immmg/simulador-de-vuelo/Actuador_Lineal_DiseñoGeneral/micro-limit-switch-1a-1.snapshot.5/sensor-final-de-carrera.jpg

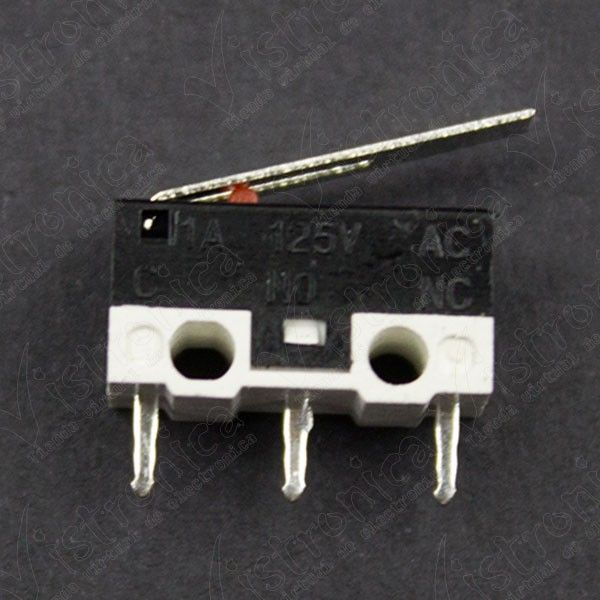
Actuador_Lineal_DiseñoGeneral/micro-limit-switch-1a-1.snapshot.5/sensor-final-de-carrera.jpg
