immmg/simulador-de-vuelo/README.md

# Simulador de Vuelo
Detalles
---
Aqui se subiran todos los detalles referentes al proyecto de diseno de sistemas, el simulador de vuelo
