immmg/simulador-de-vuelo/Especificacion de Requerimientos/Especifiaciones.md

# Especifiacion de requerimientos
* Peso total de carga: `300kg`
* Aviones soportados en la simulacion:
* Programas soportados: `Microsoft Flight Simulator X`
* Volumen Total: 
* Portable y de facil almacenamiento
* Peso total del simulador:
* Controlador: `Arduino Uno`
* Numero de Usuarios: `1`
