immmg/simulador-de-vuelo/Especificacion de Requerimientos/Documento Requerimientos Tecnicos.pdf

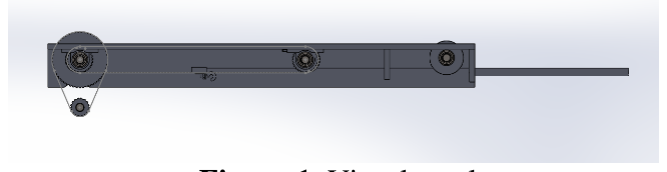
[picture p9: figure]

Mechatronics Engineering Department | Diseño de Sistemas Mecatrónicos
Universidad Católica Boliviana “San Pablo” – Santa Cruz Unit

# Especificaciones Técnicas de un Actuador Lineal para un Simulador de Vuelo

Diego García Bouron
9no. Semestre

Gerardo Viscarra
9no. Semestre

David Aguilera
9no. Semestre

Fernando Soto
9no. Semestre

Germán Ulloa
9no. Semestre

Ing. Erik Pozo
Diseño de Sistemas Mecatrónicos

Abstract—En este documento se describen cuáles son las características técnicas más importantes del actuador lineal que se está diseñando como trabajo final de la materia de Diseño de Sistemas Mecatrónicos.

I. INTRODUCCIÓN
Desde la primera mitad del siglo XX se empezaron a desarrollar simuladores de vuelo para entrenar a pilotos principiantes y evitar siniestros debido a la falta de experticia.

El primer simulador de vuelo fue desarrollado por la compañía francesa Antoinette en 1910 por iniciativa de comandantes de la fuerza aérea francesa. Este simulador contaba con un marco y un barril para reproducir la cabina de vuelo (Vincenzi, Wise, Mouloua, & Hancock, 2009).

Con el paso del tiempo y las necesidades que surgieron debido a las dos guerras mundiales, fueron apareciendo simuladores cada vez más avanzados y sofisticados como el de Edwin Link, el cual contaba con actuadores neumáticos. Este simulador fue muy utilizado por la compañía de correo estadounidense y el Ejército de Estados Unidos durante la Segunda Guerra Mundial (Mechanical & Landmark, 2000).

En 1954 United Airlines compró el primer simulador que incluía sonido e imágenes fabricado por Curttis-Wright. Este fue el primer simulador de vuelo usado para aeronaves comerciales. Este simulador contaba con actuadores hidráulicos lineales (“Airline Pilots Fly Anywhere in the World - Without Leaving the Ground,” 1954).

Los actuadores hidráulicos lineales son actualmente muy utilizados en este tipo de simuladores. Sin embargo, no son el único tipo de actuadores usados. Existen muchos simuladores y propuestas de simuladores que utilizan actuadores eléctricos lineales (Van Roy, 2015).

Actuadores lineales eléctricos: En esta línea existirán una amplia gama de modelos según los motores eléctricos utilizados, siendo necesario, en la mayoría de los casos, la utilización de reductores, debido a que los motores son de operación continua.

Actuador lineal electromecánico: Ideales para realizar levantamientos, aperturas y cierres en cualquier tipo de industria.

En este proyecto se realizará un actuador lineal eléctrico compuesto por un motor DC, una correa dentada para el cambio de movimiento circular a lineal y un pistón. Los aviones modernos son sistemas que requieren de una preparación rigurosa para poder ser pilotados sin riesgo alguno para el piloto mismo y los pasajeros. Por esta razón el uso de simuladores de vuelo es algo menester dentro de la industria aeronáutica.

II. DEFINICIÓN DEL PROBLEMA
Los simuladores de vuelo se caracterizan por sus precios elevados ya que en su mayoría utilizan actuadores hidráulicos. Por esta razón son prácticamente inaccesibles para compañías aeronáuticas pequeñas como las que están presentes en nuestro país.

III. OBJETIVOS

A. Objetivo General

Aplicar los conocimientos adquiridos durante la carrera de Ingeniería Mecatrónica para desarrollar un actuador eléctrico lineal de una plataforma de simulador de vuelo de una aeronave Cessna 177.

B. Objetivos Específicos
- Realizar el diseño mecánico del actuador lineal
- Realizar el diseño eléctrico del sistema
- Realizar la programación del controlador (Arduino Uno)

IV. ESPECIFICACIONES TÉCNICAS

A. Función del Actuador
- Grados de Libertad: 1
- Tipo de movimiento: lineal
- Peso máximo admitido: 50 kg.
- Velocidad de actuación: 0.17 m/s
- Longitud de Carrera: 50,23 cm
B. Casos de Uso para Subproceso
1) Se transmite por serial una velocidad y se recibe por potenciómetro retroalimentación.
2) Se acción uno de los finales de carrera deteniendo el actuador.
V. PROPUESTA TÉCNICA
A. Diseño General

Figura 1. Vista lateral

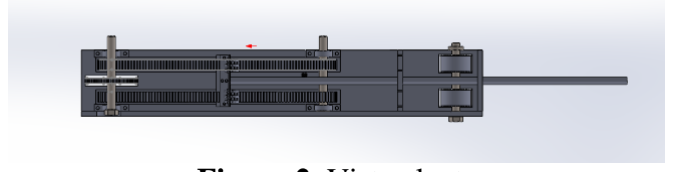
[picture p10: figure]

Figura 2. Vista planta

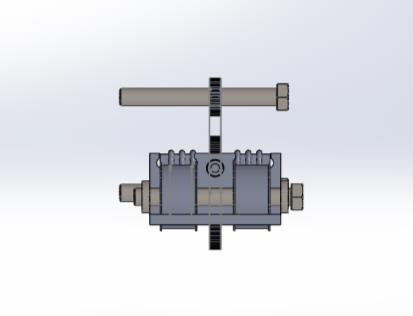
[picture p11: figure]

Figura 3. Vista frontal

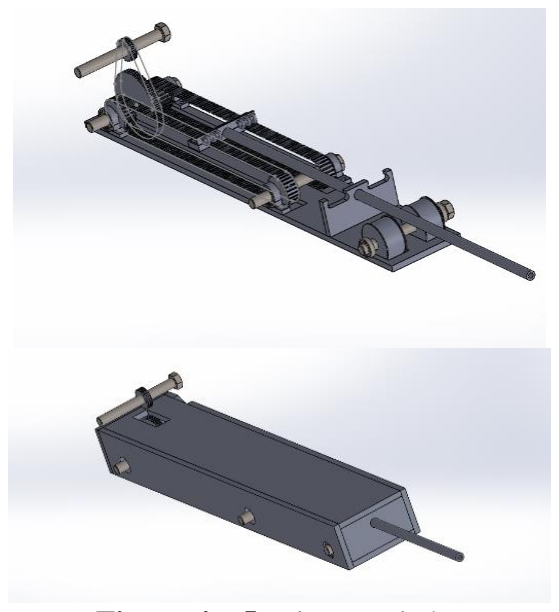
[picture p12: figure]

Figura 4 y 5. Vistas variadas

Existen vistas detalladas por pieza. Véase anexo de planos de piezas

B. Materiales y Descripcion
El actuador al estar construido constituirá de los componentes descritos en la tabla 1.

Tabla 1. Resumen de componentes presentes en el actuador

C. Diseño Estructural
a. Cálculo de Poleas
El sistema de poleas empleado en el proyecto es el que se muestra en la figura 6. La polea 1 está conectada directamente al motor, por lo tanto, esta recibe la velocidad y torque del motor.

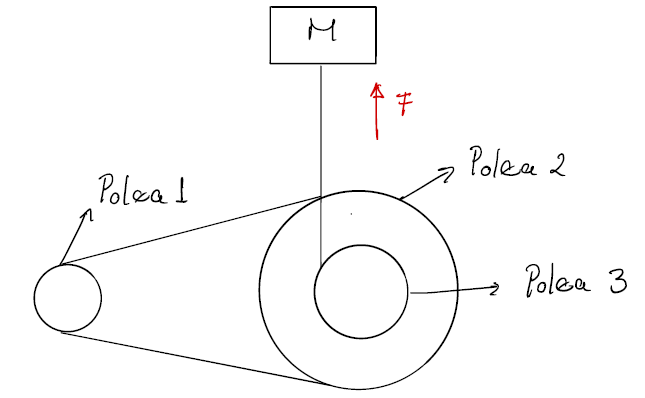
[picture p13: figure]

Figura 6. Sistema de Poleas

Se determinó cuál es el torque de salida y el esfuerzo que soporta, siendo las variables utilizadas las siguientes:
i = relación de transmisión
w1 = velocidad angular polea 1 [rpm]
w2 = velocidad angular polea 2 [rpm] w3 = velocidad angular polea 3 [rpm] F = Fuerza [N]
τ
1 = torque polea 1 [Nm]
τ
2 = torque polea 2 [Nm]
τ
3 = torque polea 3 [Nm]
r1 = radio polea 1 [m]
r2 = radio polea 1 [m]
r3 = radio polea 1 [m]
Se sabe que los valores de los radios son los siguientes:

1

2

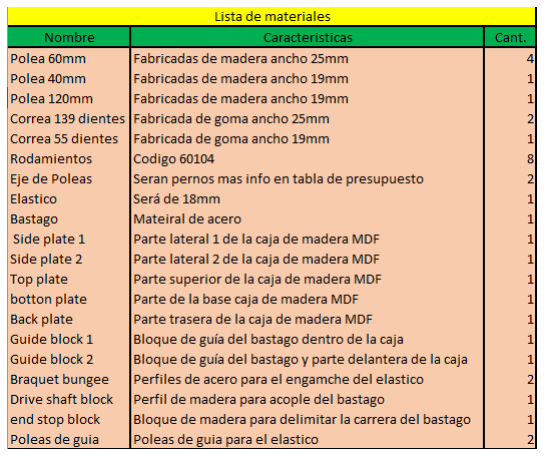
[picture p14: figure]

3

1

1

0.02
0.06
0.03
2.2
161
r | m
r | m
r | m
| Nm
| rpm

τ
ω

=
=
=
=
=

La ecuación de torque es:

### τ =· Fr

(1)

La relación de velocidades y radios es:

1 | 1 | 2 | 2
1 | 2
2 | 1

1

r r
r
r | i
ω | ω
ω
ω
- = ·

= =

(2)

La relación de velocidades y torques es:

1 | 1 | 2 | 2
1 | 2
2 | 1

1
i

### τ ω τ ω

τ | ω
τ | ω
- | = | ·
= | =

(3)

Partiendo de la ecuación (2), tenemos que:

1

2

0.02
0.06
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
Usando la ecuación (3) y como la polea 3 está en el mismo eje que polea 2, se tiene:

3 1

3

| 3
| 3

6.6

6.6 220
0.03

i
Nm

F
r
Nm F | N
m

ττ
τ
τ

=·
=

=

= | =

Por lo tanto, la fuerza que soporta el motor es de 220N

b. Cálculo de elásticos

En este proyecto se utiliza elástico de lycra que tiene la cualidad de estirarse hasta un 500% sin que se rompa. Esta cuerda se utiliza como el elástico que ayudará al motor a soportar los 50 kg deseados, como se puede ver en la figura 7. Para esto se determinó su coeficiente de elasticidad experimentalmente usando una cuerda de 1.3m que es el largo que se usará en este actuador y luego sometimos a diferentes esfuerzos para calcular diferentes coeficientes de elasticidad con la ecuación (2).

F | k x = - · (4) F
k | x
=-
(5)

Siendo:
k = coeficiente de elasticidad [N/m] F = fuerza empleada [N]
x = deformación [m]

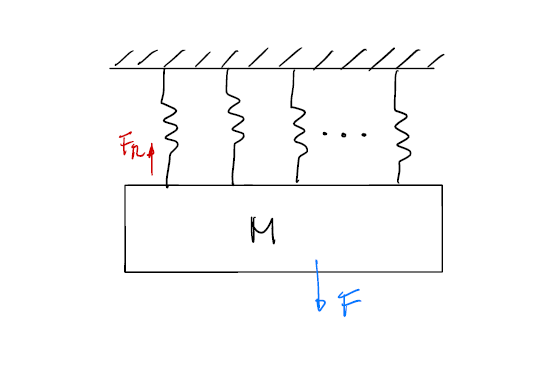
[picture p15: figure]

Figura 7. Sistema de Elásticos

En las pruebas realizadas se obtuvieron varios coeficientes de elasticidad con diferentes medidas de elásticos para comprobar la veracidad de las mismas. Se utilizaron las medidas de 0.25m, 0.5m, 1m y 1.3m y se concluyó que al variar la longitud del elástico la constante cambia. Entonces, mientras la cuerda sea más larga el coeficiente de k será menor.
En la Tabla 2 se muestran los datos obtenidos experimentalmente de la constante k.

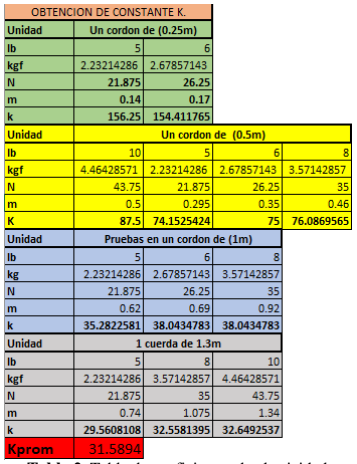
[picture p16: figure]

Tabla 2. Tabla de coeficientes de elasticidad y esfuerzos aplicados

Se sabe que la salida de la polea 3 es de 220 N que dividido por la fuerza de gravedad (9.8m/s^2) da como resultado 22 kg aproximadamente. Esto significa que nuestro elástico debe soportar 27.55 kg para cumplir con los 50 kg deseados. Por lo tano:

27.55

270

m | kg

### F m g

F N

=
=·
≅

Sabiendo que una cuerda de 1.3m tiene un coeficiente de elasticidad k=31.6nN/m y que la máxima deformación permitida es de 0.7m, con la ecuación (1) se determina que el esfuerzo que puede soportar un elástico es el siguiente:

31.6 | 0.7 | 22.12 N
F | m | N
m
= | · | =

Como se desea cargar 270N, dividimos el esfuerzo deseado entre lo que soporta un solo elástico y de esta manera sacamos la cantidad de elásticos necesarios.

270 12.27
22

=

Utilizando un factor de seguridad del 1.2 se calcula la cantidad de elásticos final con la siguiente formula:

e f | e n | n n = | ·

nef = # de elásticos final
ne = # de elásticos
n = factor de seguridad

Por lo tanto, el número de elásticos final es de 15 elásticos como se aprecia en la ecuación (3):

12.27 1.2 15 ef n = | · | ≅
(6)
c. Lista de Materiales Mecánicos

Los materiales mecánicos a utilizar y sus precios se muestran en la tabla 3.

Tabla 3. Materiales Mecánicos y Precios

Para encontrar una versión de mayor calidad de la tabla 3 véase anexos.

D. Diseño Electrico
a. Voltaje necesario: 19V
b. Corriente Necesaria:
Tomando en cuenta la ecuación (7) de la corriente del motor DC en función de la fuerza requerida (Ogata, 2013), se puede sacar la corriente necesaria:

a
t

F
I
k

=
(7)

Donde:
Ia = Corriente requerida [A]
F = Fuerza requerida [N]
Kt = constante electromecánica del motor [N/A]

Sabemos que el torque del motor es 2.2Nm, el radio de la polea 1 es 0.002m. Si utilizamos la ecuación
(1) podemos obtener la fuerza requerida.
E. Analisis de motores y eleccion

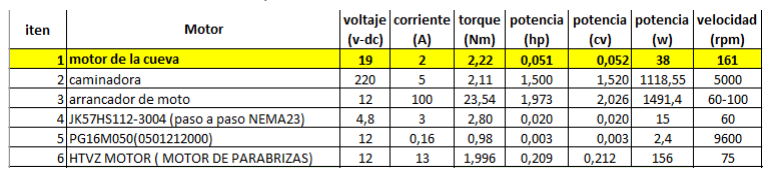
[picture p17: figure]

Tabla 4. Análisis de motores candidatos

Para encontrar una versión de mayor calidad de la tabla 4 véase anexos.

Se utilizará el motor de la cueva ya que este cumple con los requisitos buscados para este proyecto, que son un buen par motor, y consumo aceptable, en comparación a las demás propuestas, el siguiente a ser escogido es el motor caminador, por la disponibilidad inmediata. El siguiente será el arrancador de moto.

F. Velocidad Máxima del Actuador sin carga
Tomando en cuenta que la relación del sistema obtenida en la sección C.a fue de 1/3 y que la velocidad del actuador elegido es de 161 rpm se puede calcular a través de la siguiente formula la velocidad de salida:
ωf = i ∙ ωi

Entonces:
ωf ≅ 54 rev/min

Convirtiendo a rad/seg:

54

rev
min

∙

2π rad
1 rev

∙

1 min
60 s

= 5.7

rad
seg

Sabiendo que la fórmula para transformar velocidad angular a lineal es:
V = ω ∙ r

Y sabiendo que el radio de la polea de salida es 0.03m, entonces:

V = 5.7

rad
seg

∗ 0.03m

V = 0.17

m
s
G. Elección de Fuente
Esta fuente tiene las siguientes características: 24Vdc y 5A. Ya que el consumo del motor es de 19V y 3A. La figura 8 muestra una fuente comercial de estas características

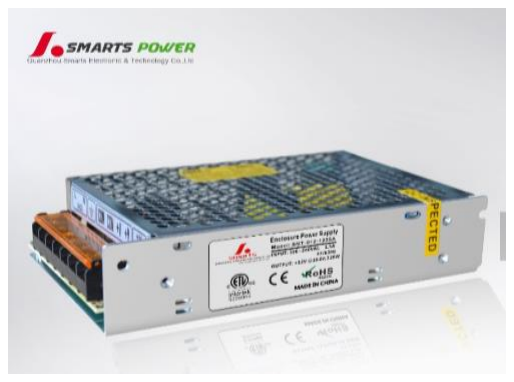
[picture p18: figure]

Figura 8. Imagen ilustrativa del tipo de fuente

H. Diseño Electronico y computacional
a. Diseño Electrónico

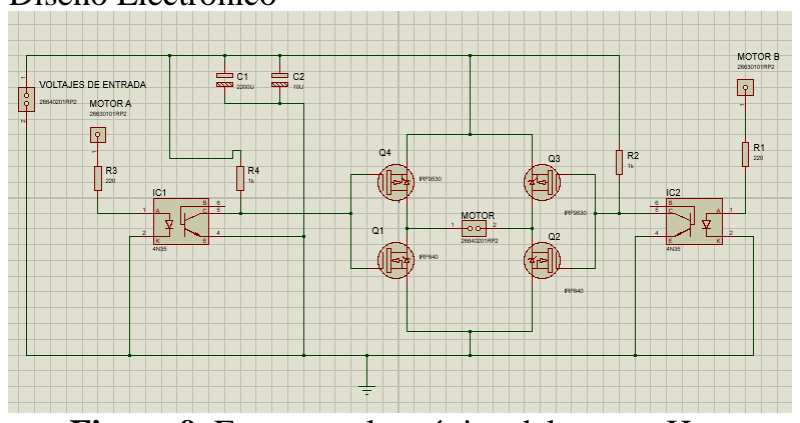
[picture p19: figure]

Figura 9. Esquema electrónico del puente H

Descripcion | Codigo | Precio/Item | Cant. | Subtotal [BOB] 135 160 50 33 180 60 10 106,8 40
Venesta de MDF 1.83 x 1.375 12mm Rodamientos Pernos 20M - 140 longitud Venesta de MDF 2,8mm Correa 25M Correa 19M Pernos M6 Elastico Ganchos | 61904 24018 Precio por metro | 135,00 20,00 25,00 33,00 90,00 60,00 0,50 8,90 2,00 | 1 8 2 1 2 1 20 12 20
SUBTOTAL | | | | 774,8

PRESUPUESTO DE PARTES MECANICAS

La figura 9 muestra el esquema electrónico del puente H propuesto para el control de giro y velocidad del actuador. Para mayor detalle véase Anexo de Plano Electrónico

b. Lista de Materiales Electrónicos
Los materiales electrónicos utilizar y sus precios se muestran en la tabla 5. Existe una versión más detallada en los anexos

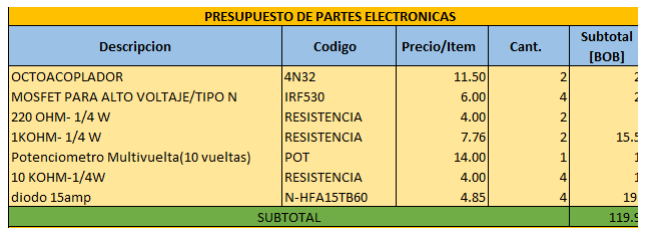
[picture p20: figure]

Tabla 5. Materiales Electrónicos y precios

c. Diseño computacional
Al usar Arduino para el control del actuador se utilizara por conveniencia el Arduino IDE, el cual fuerza a usar una estructura de programa con dos funciones básicas, una de ajuste y otra de repetición infinita como se muestra en el diagrama de flujo de la figura 10. Una versión de más detalle de este diagrama existe en los anexos


Figura 10. Diagrama de flujo de programación

- Interfaz de usuario: Monitor serial de Arduino IDE
- Entradas: Potenciómetros, Final de Carrera
- Salidas: Control PWM
I. Cronograma
Véase anexo de cronograma
J. Propuesta Economica
La propuesta económica es de 1302.88 bolivianos (Véase anexos).

VI. REFERENCIAS

Ogata, K. (2013). Ingeniería de Control Moderna. Journal of Chemical
Information | and | Modeling | (Vol. | 53).
https://doi.org/10.1017/CBO9781107415324.004

Van Roy, R. (2015). Simproject.nl.
Airline Pilots Fly Anywhere in the World - Without Leaving the Ground. (1954). Popular Mechanics.
Mechanical, A. H., & Landmark, E. (2000). The Link Flight Trainer. Vincenzi, D. A., Wise, J. A., Mouloua, M., & Hancock, P. A. (Eds.). (2009). Human Factors in Simulation and Training. CRC Pr

ID | Nombre de tarea | Duration | Start | Finish | Predecessors
1 | Actudor Lineal para plataforma de simulador de Vuelo 79,25 days | | Mon 1/4/19 | Fri 21/6/19
2 | Definición de Cronograma | 5 days | Mon 1/4/19 | Fri 5/4/19
3 | Diseño Estructural | 73,38 days | Mon 1/4/19 | Sat 15/6/19
4 | Busqueda de Bibliografía | 2 days | Mon 1/4/19 | Tue 2/4/19
5 | Diseño de Partes Estructurales | 5 days | Wed 3/4/19 | Tue 9/4/19 | 4
6 | Selección de materiales a ser utilizadas2 days | | Wed 10/4/19 | Thu 11/4/19 | 5
7 | Determinar presupuesto de partes | 2 days | Thu 25/4/19 | Fri 26/4/19
8 | Compra de materiales | 2 days | Sat 18/5/19 | Mon 20/5/19 | 6
9 Mecanisado de Poleas con la | cortadora 3D | 5 days | Tue 21/5/19 | Sun 26/5/19 | 8
10 Cortado de las piezas de la caja del | actuador con la cortadora 3D | 8 days | Wed 22/5/19 | Thu 30/5/19
11 | Prueba de resistencia de las poleas | 2 days | Sun 26/5/19 | Tue 28/5/19 | 9
12 | Ensamblado de la estructura | 10 days | Fri 31/5/19 | Mon 10/6/19
13 | Pruebas Mecanicas del actuador | 10 days | Wed 5/6/19 | Sat 15/6/19
14 | Diseño Eléctrico | 52,5 days | Mon 1/4/19 | Sat 25/5/19
15 | Busqueda de Bibliografía | 2 days | Mon 1/4/19 | Tue 2/4/19
16 Diseño de Circuitos de Alimentación | Eléctrica | 3 days | Wed 3/4/19 | Fri 5/4/19 | 15
17 | Materiales eléctricos a utilizar | 2 days | Sat 6/4/19 | Mon 8/4/19 | 16
18 | Presupuesto Electrico | 38,75 days | Mon 1/4/19 | Fri 10/5/19
19 | Compra de materiales | 3 days | Sat 11/5/19 | Tue 14/5/19 | 18
20 Documento de Comparacion de | Motores | 5 days | Mon 22/4/19 | Fri 26/4/19
21 Ensablado de circuito de | alimentacion | 10 days | Wed 15/5/19 | Sat 25/5/19 | 19
22 | Pruebas del circuito de alimentacion | 3 days | Fri 26/4/19 | Mon 29/4/19
23 | Obtencion de parametros del motor | 4 days | Fri 10/5/19 | Tue 14/5/19
24 | Modelo matematico del motor Toshiba9 days | | Wed 10/4/19 | Fri 19/4/19
25 | Diseño Electrónico / Computacional | 69,75 days | Mon 1/4/19 | Wed 12/6/19
26 | Busqueda de Bibliografía | 2 days | Mon 1/4/19 | Tue 2/4/19
27 | Diseño de Circuito Electrónicos | 2 days | Wed 3/4/19 | Thu 4/4/19 | 26
28 Diseño Computacional y Algoritmos | de Drivers | 1 wk | Wed 3/4/19 | Mon 8/4/19 | 26
29 | Materiales Electrónicos | 3 days | Mon 8/4/19 | Thu 11/4/19 | 28
30 | Presupuesto Electrónico | 15 days | Thu 25/4/19 | Fri 10/5/19
31 | Compra de materiales electronicos | 5,75 days | Sat 11/5/19 | Thu 16/5/19 | 30
32 | Diseño de interfaz de control | 32 days | Fri 10/5/19 | Wed 12/6/19
33 Diseño del diagrama de bloques del | sistema | 15 days | Thu 9/5/19 | Fri 24/5/19
34 | Propuesta Económica | 3 days | Thu 25/4/19 | Sun 28/4/19 | 29

Encargado | % Complete
Todo el equipo | 25%

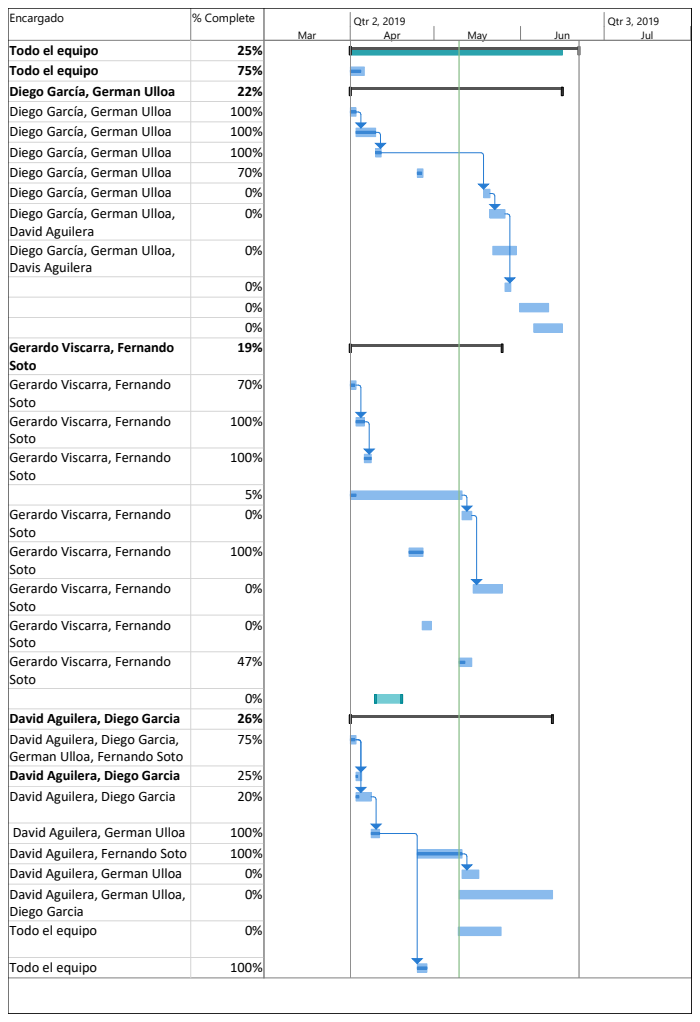
[picture p21: page 7]
Mar; Apr; May; Jun; Jul; Qtr 2, 2019; Qtr 3, 2019

Todo el equipo | 75%
Diego García, German Ulloa | 22%
Diego García, German Ulloa | 100%
Diego García, German Ulloa | 70%
Diego García, German Ulloa | 0%
Diego García, German Ulloa, David Aguilera | 0%

Diego García, German Ulloa, Davis Aguilera | 0%

0%

Gerardo Viscarra, Fernando Soto | 19%

Gerardo Viscarra, Fernando Soto | 70%

Gerardo Viscarra, Fernando Soto | 100%

Gerardo Viscarra, Fernando Soto | 0%

Gerardo Viscarra, Fernando Soto | 47%

David Aguilera, Diego Garcia | 26%
David Aguilera, Diego Garcia, German Ulloa, Fernando Soto | 75%

David Aguilera, Diego Garcia | 25%
David Aguilera, Diego Garcia | 20%

David Aguilera, German Ulloa | 100%
David Aguilera, Fernando Soto | 100%
David Aguilera, German Ulloa | 0%
David Aguilera, German Ulloa, Diego Garcia | 0%

Todo el equipo | 0%

Todo el equipo | 100%

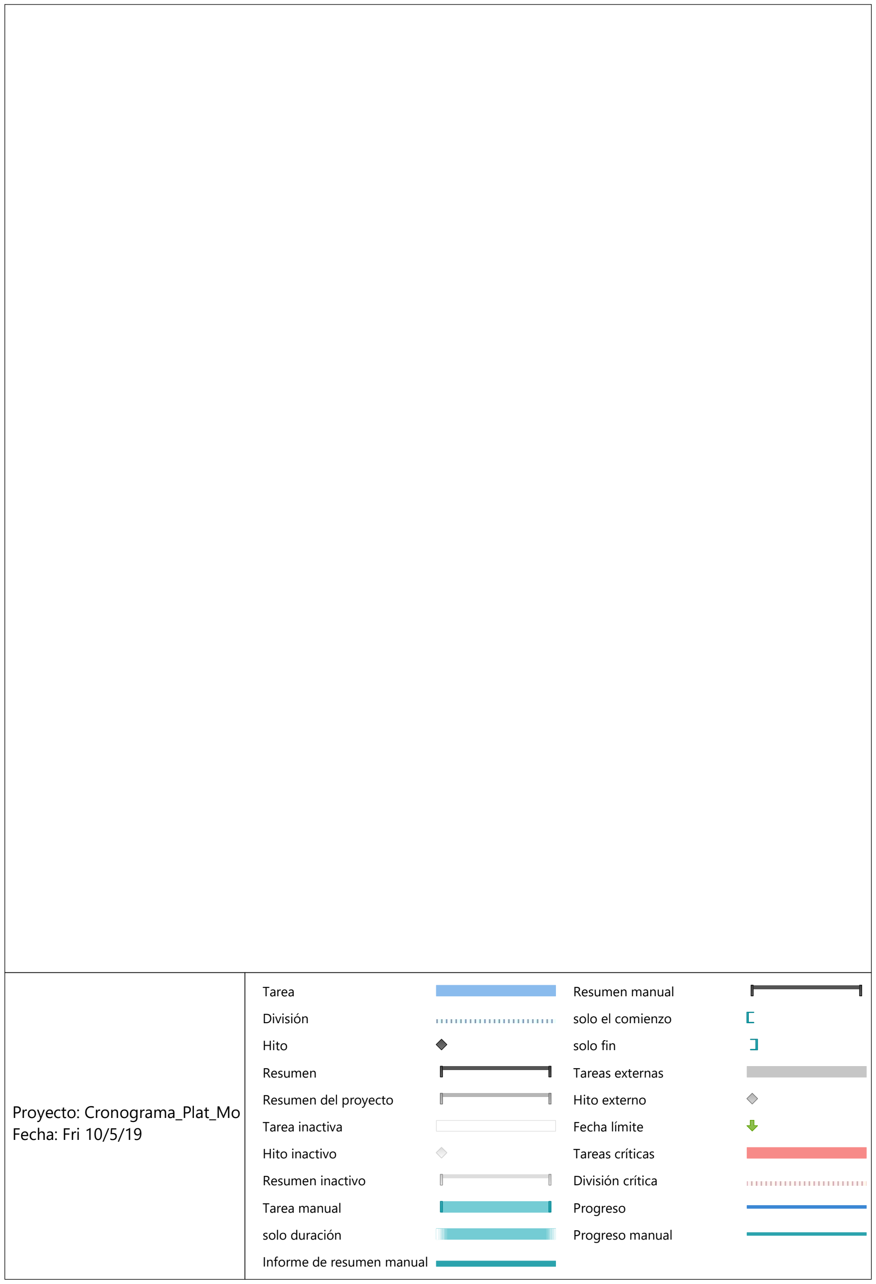
[picture p22: figure]
Tarea; División; Hito; Resumen; Resumen del proyecto; Tarea inactiva; Hito inactivo; Resumen inactivo; Tarea manual; solo duración; Informe de resumen manual; Resumen manual; solo el comienzo; solo fin; Tareas externas; Hito externo; Fecha límite; Tareas críticas; División crítica; Progreso; Progreso manual; Proyecto: Cronograma_Plat_Mo Fecha: Fri 10/5/19

### Lista de Materiales Mecanicos Presentes en el Actuador

Nombre | Caracteristicas | Cant.
Polea 60mm | Fabricadas de madera ancho 25mm | 4
Polea 40mm | Fabricadas de madera ancho 19mm | 1
Polea 120mm | Fabricadas de madera ancho 19mm | 1
Correa 139 dientes | Fabricada de goma ancho 25mm | 2
Correa 55 dientes | Fabricada de goma ancho 19mm | 1
Rodamientos | Codigo 60104 | 8
Eje de Poleas | Seran pernos mas info en tabla de presupuesto | 2
Elastico | Será de 18mm | 1
Bastago | Mateiral de acero | 1
Side plate 1 | Parte lateral 1 de la caja de madera MDF | 1
Side plate 2 | Parte lateral 2 de la caja de madera MDF | 1
Top plate | Parte superior de la caja de madera MDF | 1
botton plate | Parte de la base caja de madera MDF | 1
Back plate | Parte trasera de la caja de madera MDF | 1
Guide block 1 | Bloque de guía del bastago dentro de la caja | 1
Guide block 2 | Bloque de guía del bastago y parte delantera de la caja | 1
Braquet bungee | Perfiles de acero para el engamche del elastico | 2
Drive shaft block | Perfil de madera para acople del bastago | 1
end stop block | Bloque de madera para delimitar la carrera del bastago | 1
Poleas de guia | Poleas de guia para el elastico | 2

Lista de materiales

### Obtencion de Constante K - Resultados de los experimentos

Unidad | Un cordon de (0.25m)
lb | 5 | 6
kgf | 2.23214286 | 2.67857143
N | 21.875 | 26.25
m | 0.14 | 0.17
k | 156.25 | 154.411765
Unidad | Un cordon de (0.5m)
lb | 10 | 5 | 6 | 8
kgf | 4.46428571 | 2.23214286 | 2.67857143 | 3.57142857
N | 43.75 | 21.875 | 26.25 | 35
m | 0.5 | 0.295 | 0.35 | 0.46
K | 87.5 | 74.1525424 | 75 | 76.0869565
Unidad | Pruebas en un cordon de (1m)
lb | 5 | 6 | 8
kg | 2.23214286 | 2.67857143 | 3.57142857
N | 21.875 | 26.25 | 35
m | 0.62 | 0.69 | 0.92
k | 35.2822581 | 38.0434783 | 38.0434783
Unidad | 1 cuerda de 1.3m
lb | 5 | 8 | 10
kgf | 2.23214286 | 3.57142857 | 4.46428571
N | 21.875 | 35 | 43.75
m | 0.74 | 1.075 | 1.34
k | 29.5608108 | 32.5581395 | 32.6492537
Kprom | 31.5894

OBTENCION DE CONSTANTE K.

### Analisis de Motores

item | Motor | voltaje(v-dc) | corriente(A) | torque(Nm) | potencia(hp) | potencia(cv) | potencia(w) | velocidad(rpm)
1 2 3 4 5 6 | motor de la cueva caminadora arrancador de moto JK57HS112-3004 (paso a paso NEMA23) PG16M050(0501212000) HTVZ MOTOR (motor de parabrisas) | 19,000 220,000 12,000 4,800 12,000 12,000 | 2,000 5,000 100,000 3,000 0,160 13,000 | 2,222 2,106 23,540 2,800 0,980 1,996 | 0,051 1,500 1,973 0,020 0,003 0,209 | 0,052 1,520 2,026 0,020 0,003 0,212 | 38,000 1118,550 1491,400 15,000 2,400 156,000 | 161,000 5000,000 60-100 60,000 9600,000 75,000

82,00

# Botton plate - planta

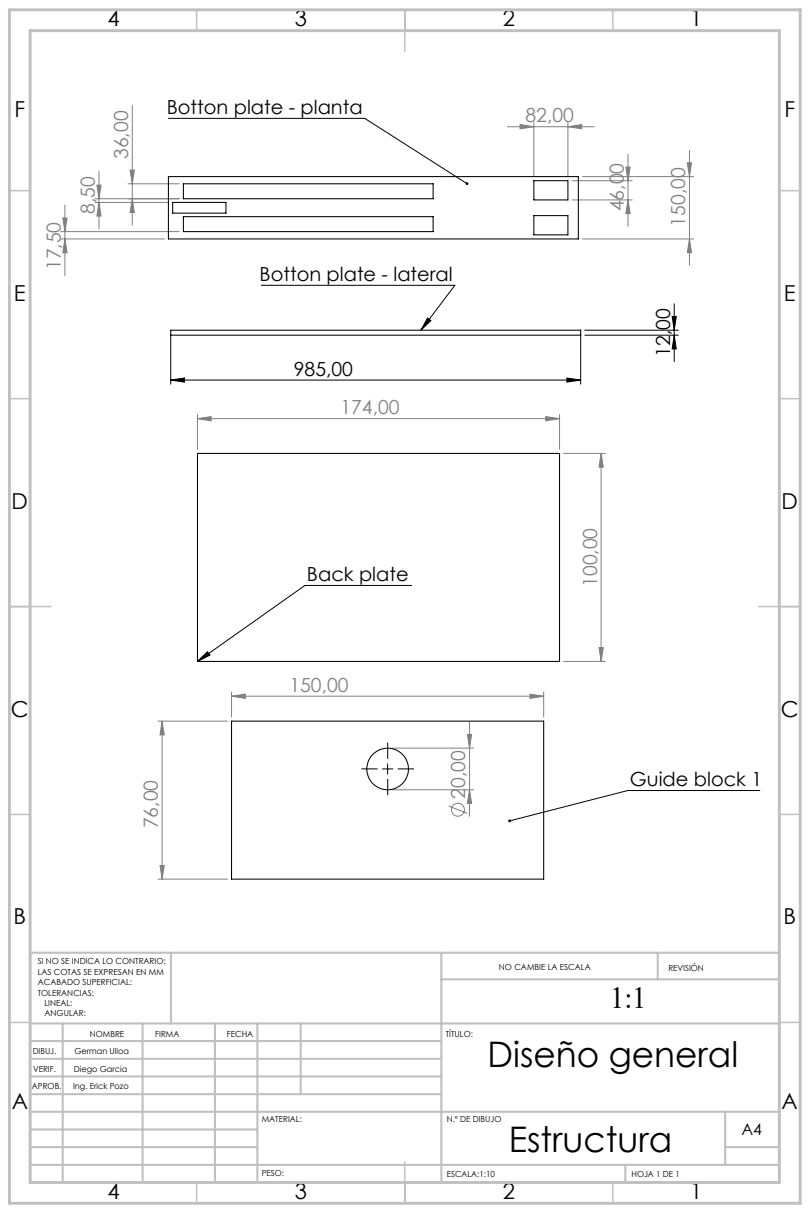
[picture p23: page 12]
Back plate; Guide block 1; MATERIAL:; NO CAMBIE LA ESCALA; REVISIÓN; N.º DE DIBUJO; ESCALA:1:10; HOJA 1 DE 1; PESO:; Estructura

Botton plate - lateral

SI NO SE INDICA LO CONTRARIO:
LAS COTAS SE EXPRESAN EN MM
ACABADO SUPERFICIAL:
TOLERANCIAS:
LINEAL:
ANGULAR:

NOMBRE | FIRMA | FECHA | TÍTULO: Diseño general

DIBUJ. | German Ulloa
VERIF. | Diego Garcia
APROB. | Ing. Erick Pozo

20,00

150,00

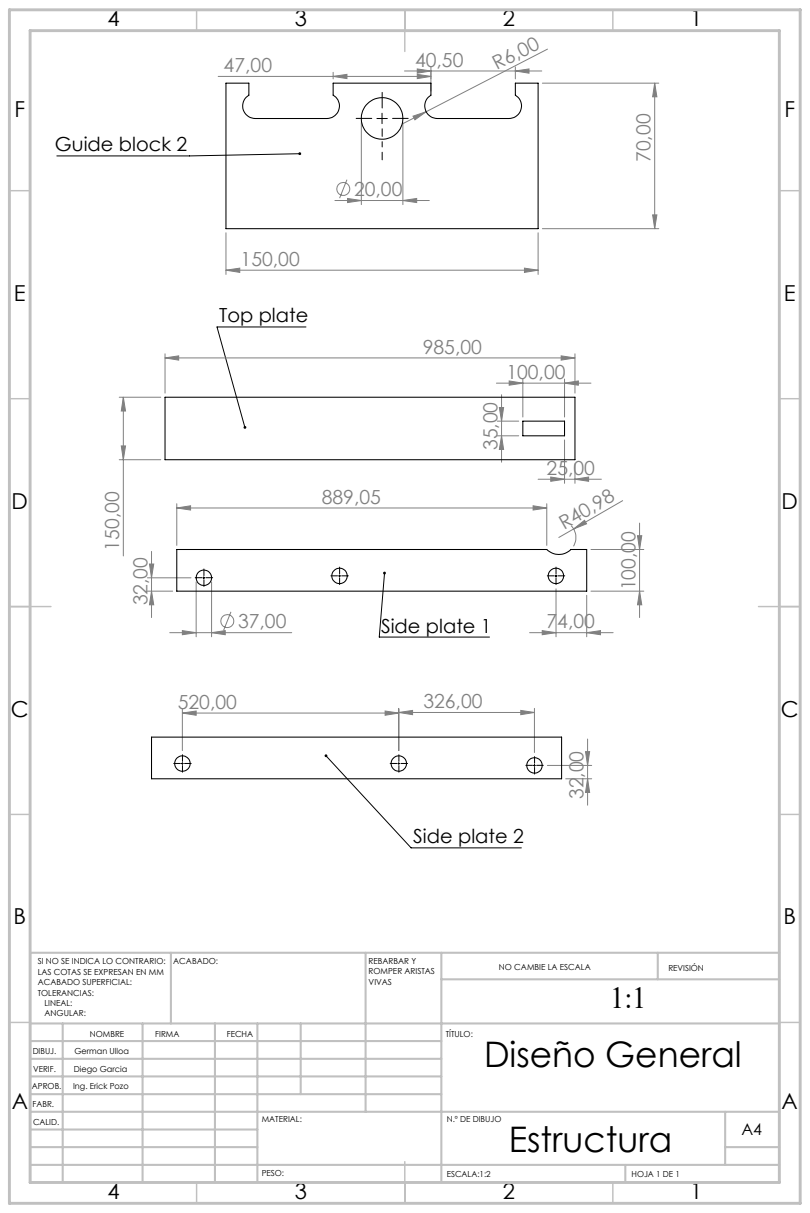
[picture p24: page 13]
Guide block 2; Top plate; Side plate 1; Side plate 2; ACABADO:; REBARBAR Y; ROMPER ARISTAS VIVAS; NO CAMBIE LA ESCALA; REVISIÓN; ESCALA:1:2; HOJA 1 DE 1; PESO:

SI NO SE INDICA LO CONTRARIO:
LAS COTAS SE EXPRESAN EN MM
ACABADO SUPERFICIAL:
TOLERANCIAS:
LINEAL:
ANGULAR:

NOMBRE | FIRMA | FECHA | | | | TÍTULO: Diseño General

DIBUJ. | German Ulloa
VERIF. | Diego Garcia
APROB. | Ing. Erick Pozo
FABR.
CALID. | | | | MATERIAL: | N.º DE DIBUJO Estructura | A4

3,00 25,00
136,00

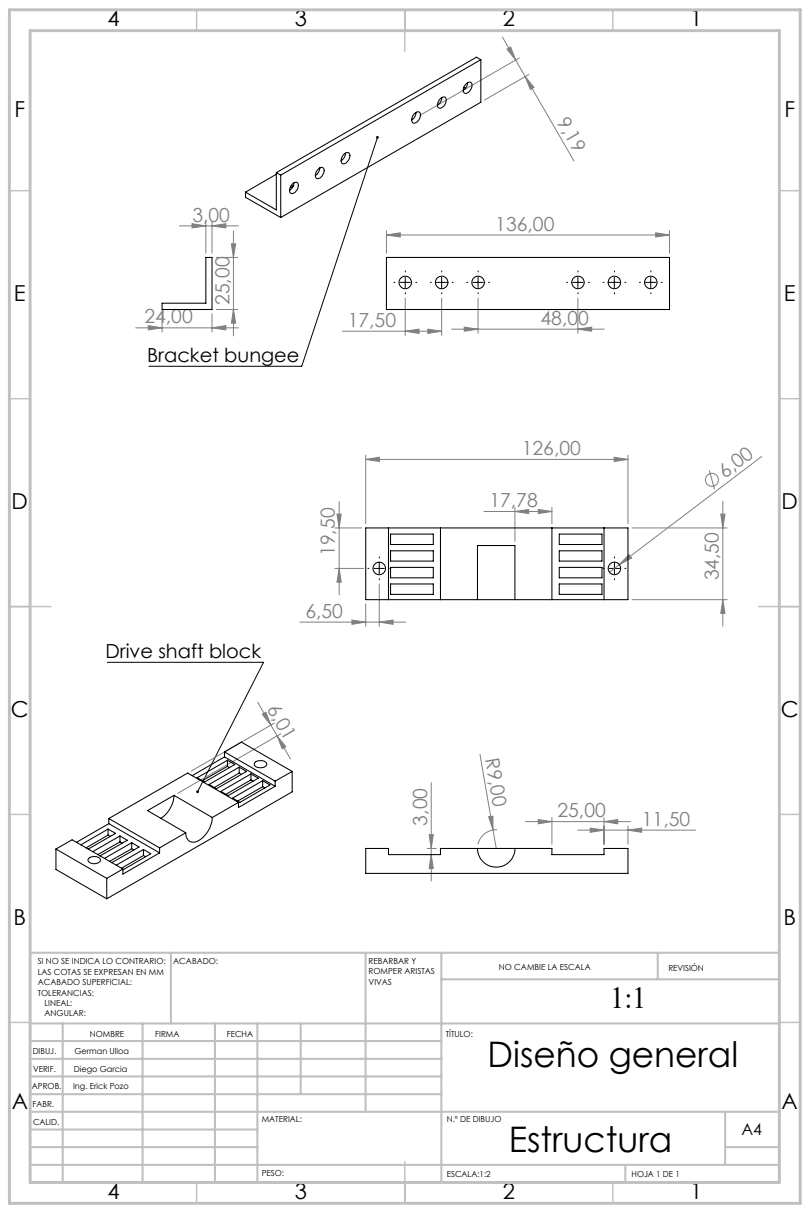
[picture p25: page 14]
Bracket bungee; ACABADO:; REBARBAR Y; ROMPER ARISTAS VIVAS; NO CAMBIE LA ESCALA; REVISIÓN; ESCALA:1:2; HOJA 1 DE 1; PESO:

Drive shaft block

SI NO SE INDICA LO CONTRARIO:
LAS COTAS SE EXPRESAN EN MM
ACABADO SUPERFICIAL:
TOLERANCIAS:
LINEAL:
ANGULAR:

NOMBRE | FIRMA | FECHA | | | | TÍTULO: Diseño general

DIBUJ. | German Ulloa
VERIF. | Diego Garcia
APROB. | Ing. Erick Pozo
FABR.
CALID. | | | | MATERIAL: | N.º DE DIBUJO Estructura | A4

# Polea de 40 mm

# Polea de 60 mm

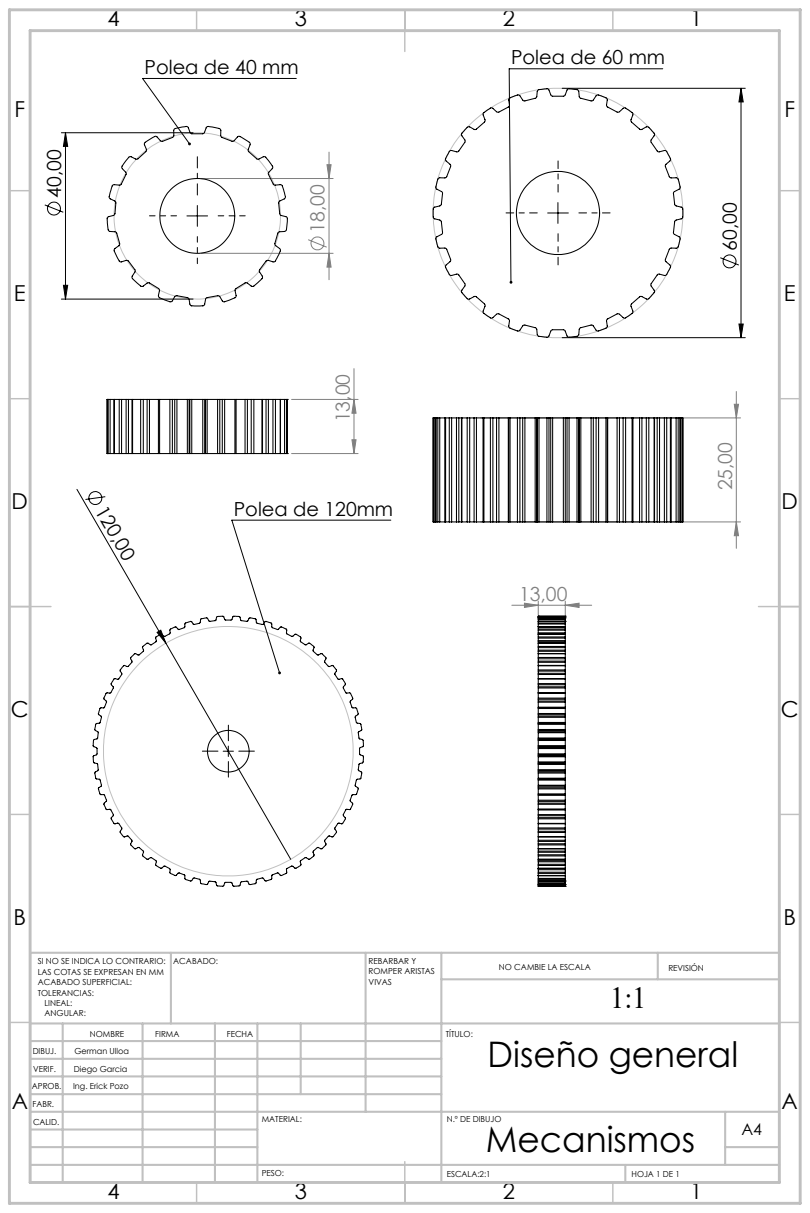
[picture p26: page 15]
Polea de 120mm; ACABADO:; REBARBAR Y; ROMPER ARISTAS VIVAS; NO CAMBIE LA ESCALA; REVISIÓN; ESCALA:2:1; HOJA 1 DE 1; PESO:

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

NOMBRE | FIRMA | FECHA | | | | TÍTULO: Diseño general

DIBUJ. | German Ulloa
VERIF. | Diego Garcia
APROB. | Ing. Erick Pozo
FABR.
CALID. | | | | MATERIAL: | N.º DE DIBUJO Mecanismos | A4

A

B

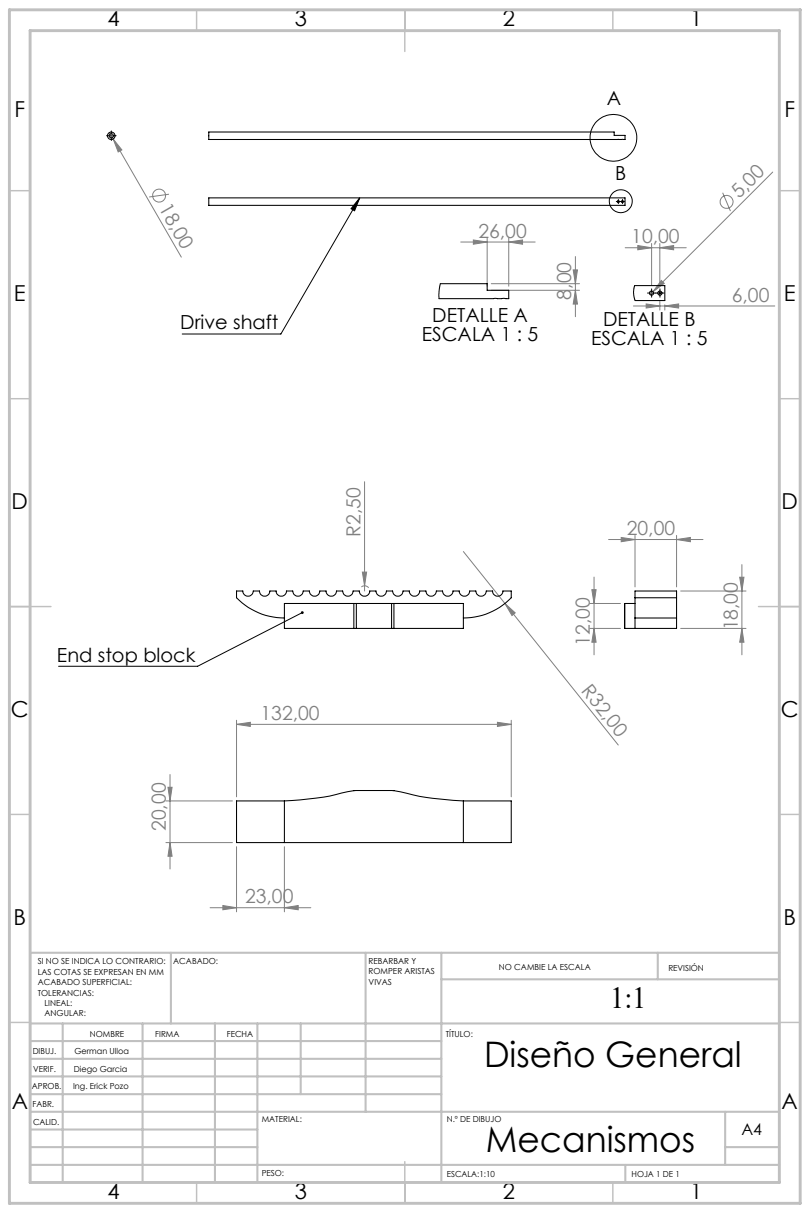
[picture p27: page 16]
Drive shaft; DETALLE A ESCALA 1 : 5; DETALLE B ESCALA 1 : 5; ACABADO:; REBARBAR Y; ROMPER ARISTAS VIVAS; NO CAMBIE LA ESCALA; REVISIÓN; ESCALA:1:10; HOJA 1 DE 1; PESO:

End stop block 20,00

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

NOMBRE | FIRMA | FECHA | | | | TÍTULO: Diseño General

DIBUJ. | German Ulloa
VERIF. | Diego Garcia
APROB. | Ing. Erick Pozo
FABR.
CALID. | | | | MATERIAL: | N.º DE DIBUJO Mecanismos | A4

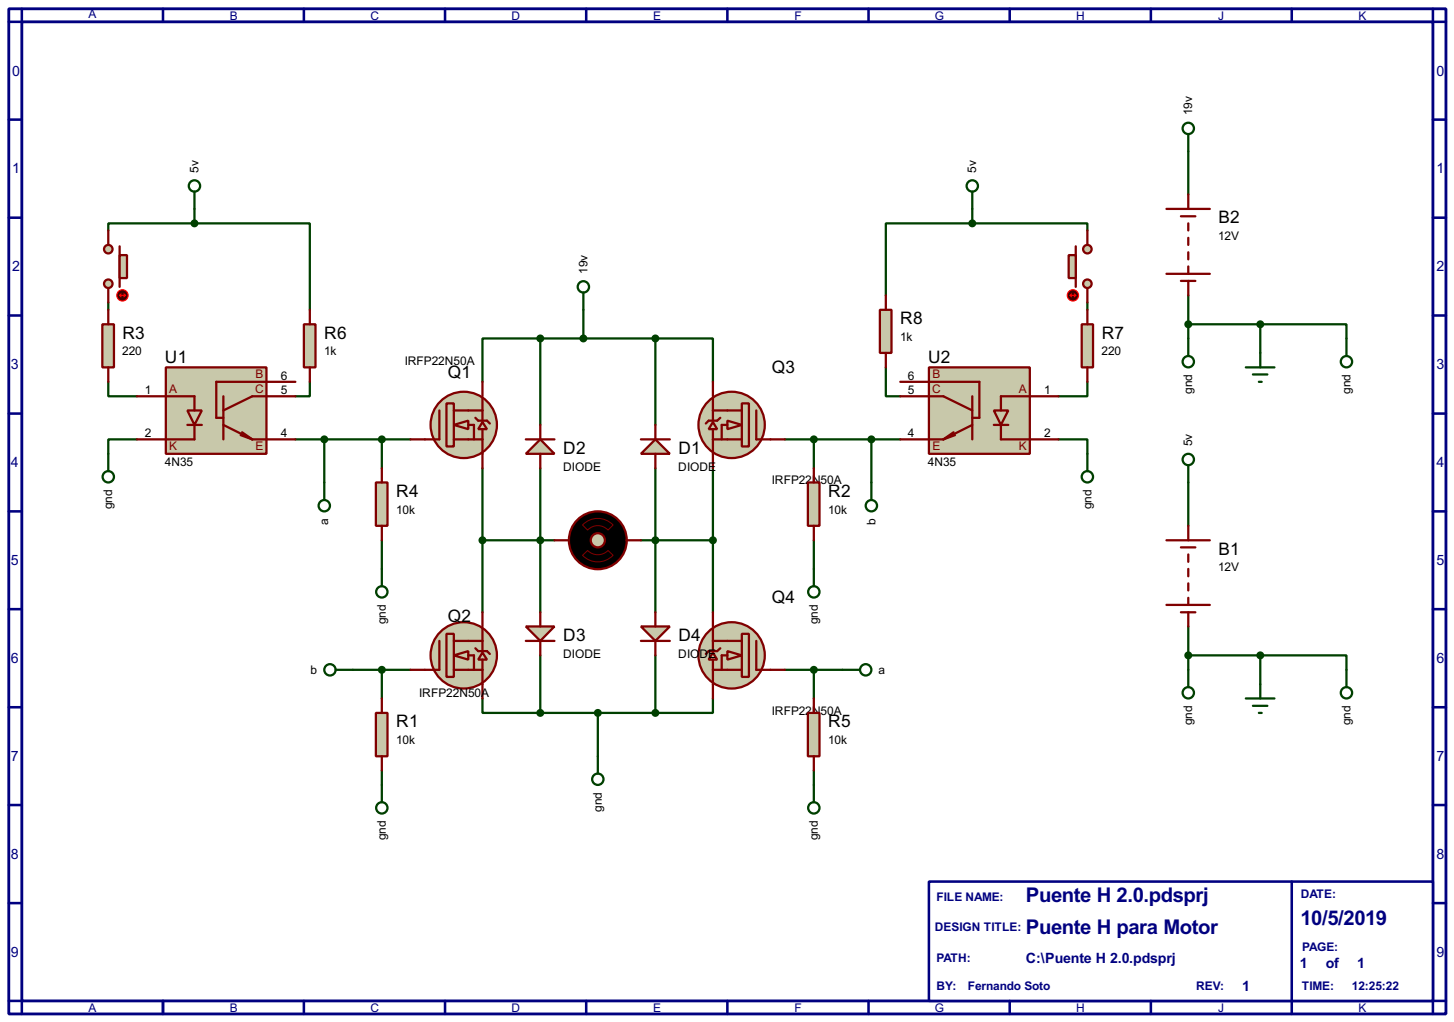
[picture p28: page 17]

FILE NAME:
DESIGN TITLE: Puente H para Motor

IMMMG INGENIERIA | https://github.com/immmg

# ACTUADOR LINEAL

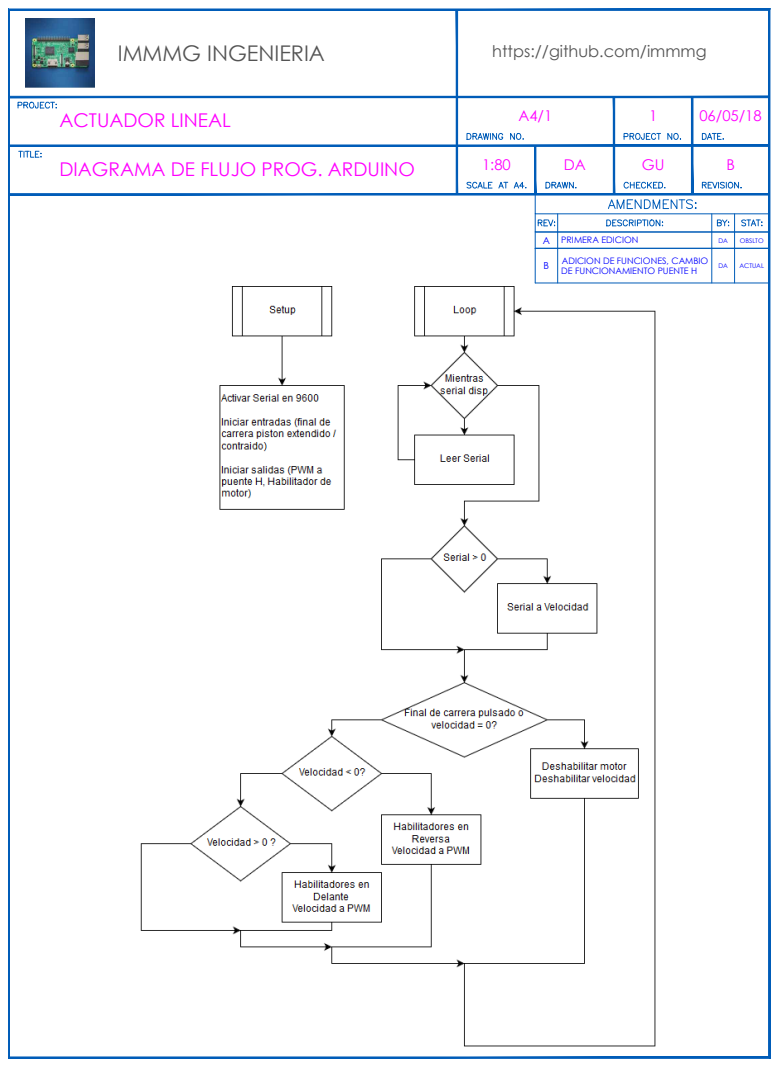
[picture p29: page 18]
PRIMERA EDICION; OBSLTO; ADICION DE FUNCIONES, CAMBIO; DE FUNCIONAMIENTO PUENTE H; ACTUAL

DIAGRAMA DE FLUJO PROG. ARDUINO
