immmg/simulador-de-vuelo/Especificacion de Requerimientos/Requisitos Técnicos.pdf

Requisitos Técnicos

Actuador Simulador de Vuelo

### 1. Función del Actuador

a. Grados de Libertad: 1
b. Tipo de movimiento: lineal
c. Peso máximo admitido: 50 kg.
d. Velocidad de actuación: 0.5 m/s
e. Aceleración de actuación:
f. Longitud de Carrera: 50,23 cm

### 2. Casos de Usos para Subprocesos

a. Caso 1: Se transmite por serial una velocidad y se recibe por potenciómetro retroalimentación.
b. Caso 2: Se acción uno de los finales de carrera deteniendo el actuador.

### 3. Interfaz de Usuario

a. Monitor serial de Arduino IDE

### 4. Entradas/Salidas

a. Entradas:
i. Potenciómetros
ii. Final de Carrera
b. Salidas: PWM

### 5. Flujo de Proceso


### 6. Sección Eléctrica

a. Voltaje Necesario: 19V
b. Corriente Necesaria:

Ia =

0.1[m] ∗ F
Kt
Kt = Constante electromecánica del motor [Nm/A] F = Fuerza necesaria [N]

### 7. Secciones Mecánica

Especificaciones de Materiales:

Diemciones de la caja [mm]

Ancho | 174
Largo | 1000
Alto | 100
Perimetro | 291400
Poleas | cantidad
60 mm | 4
40 mm | 1
120 mm | 1
Correas | | cantidad
139 Dientes 25 mm ancho | | 2
55 Dientes 13 mm ancho | | 1
carrera | cantidad
523 mm | 1
Rodamientos | cantidad
60904 | 4
eje de poleas | cantidad
20 mm x 140mm | 2
elastico | cantidad
600mm | 1
