immmg/simulador-de-vuelo/Especificacion de Requerimientos/Presupuesto Estructura.xlsx

PRESUPUESTO DE PARTES MECANICAS
Descripcion | Codigo | Precio/Item | Cant. | Subtotal
Venesta de MDF 1.83 x 1.375 12mm |  | 250.00 | 1 | 250
Rodamientos | 61904 | 90.00 | 4 | 360
Pernos 20M - 140 longitud | 24018 | 25.00 | 2 | 50
Tubo 18mm |  | 30.00 | 1 | 30
ABS |  | 50.00 | 1 | 50
Tornillo Broca |  | 50.00 | 1 | 50
Correa 25M |  | 100.00 | 2 | 200
Correa 13M |  | 60.00 | 1 | 60
Bearing |  | 38.00 | 4 | 152
Rodillos de Tension |  | 30.00 | 2 | 60
Ganchos |  | 2.00 | 12 | 24
SUBTOTAL |  |  |  | 1286
