immmg/simulador-de-vuelo/Especificacion de Requerimientos/Presupuesto.xlsx

PRESUPUESTO DE PARTES
Descripcion | Codigo | Precio/Item | Cant. | Subtotal
Venesta de MDF 1.83 x 1.375 12mm |  | 250.00 | 1 | 250
Arduino | MEGA 2560 | 130.00 | 1 | 130
OCTOACOPLADOR | 4N32 | 11.50 | 2 | 23
MOSFET PARA ALTO VOLTAJE/TIPO N | JS44N50H | 5.26 | 4 | 21.06
220 OHM- 1/4 W | RESISTENCIA | 4.00 | 2 | 8
1KOHM- 1/4 W | RESISTENCIA | 7.76 | 2 | 15.52
10 KOHM-1/4W | RESISTENCIA | 4.00 | 4 | 16
2200UF-250V | CAPACITOR | 4.00 | 1 | 4
10UF-250V | CAPACITOR | 4.00 | 1 | 4
diodo 15amp | N-HFA15TB60 | 4.85 | 4 | 19.4
puente de diodos | KBU1010 | 10.10 | 1 | 10.1
SUBTOTAL |  |  |  | 501.08
