immmg/simulador-de-vuelo/Actuador_Lineal_DiseñoGeneral/Ensamblaje 8M drive assy.SLDASM

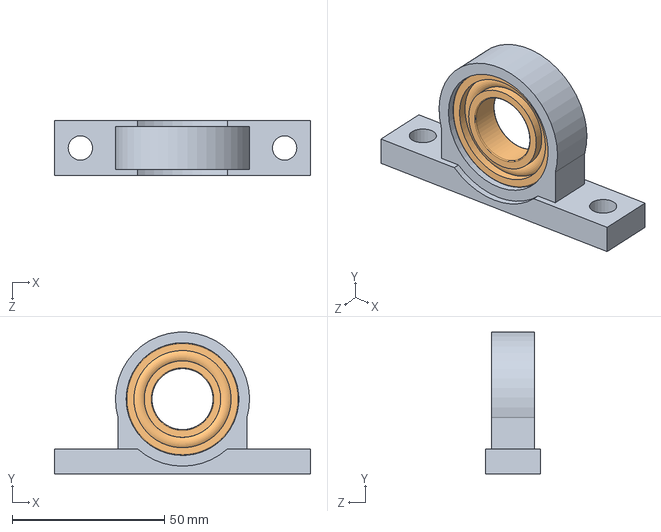
[picture p31: CAD file, 2019-04-26]
Actuador_Lineal_DiseñoGeneral/Ensamblaje 8M drive assy.SLDASM
84.0 x 46.4 x 18.0 mm
fijadores del eje
radial ball bearing_68_skf
