immmg/simulador-de-vuelo/Tren de engranajes (1)/Ensamblaje1.SLDASM

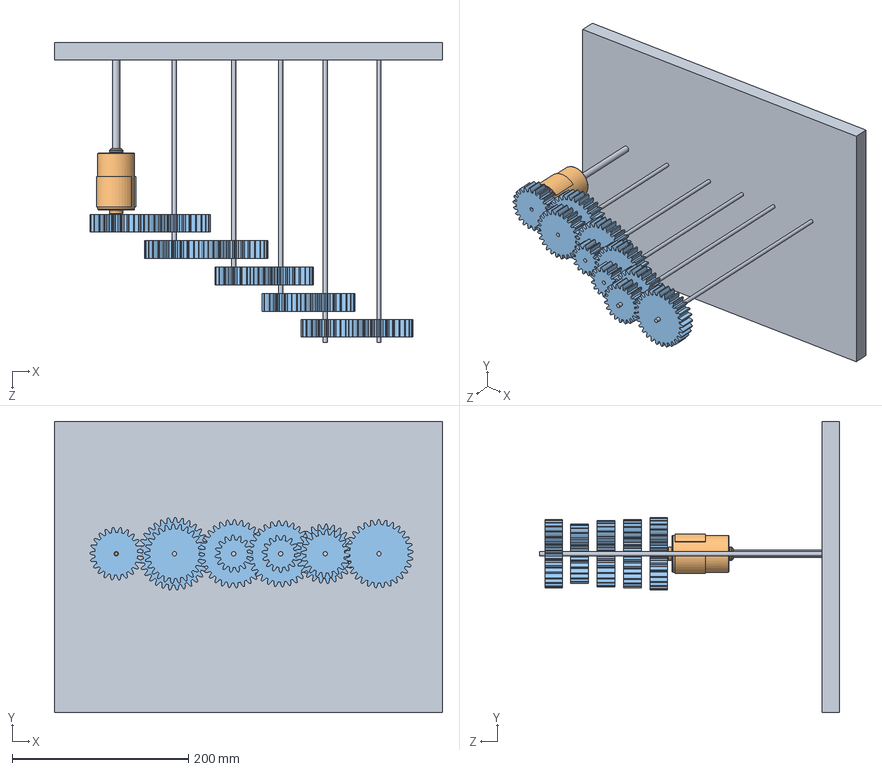
[picture p32: CAD file, 2019-04-26]
Tren de engranajes (1)/Ensamblaje1.SLDASM
440.0 x 330.0 x 340.0 mm
Base
High Speed 775 Motor Low Noise DC 12V-24V Large Torque Motor Ball Bearing Tools
spur gear_am x 10
