immmg/simulador-de-vuelo/Actuador_Lineal_DiseñoGeneral/EnsambleDePoleas.SLDASM

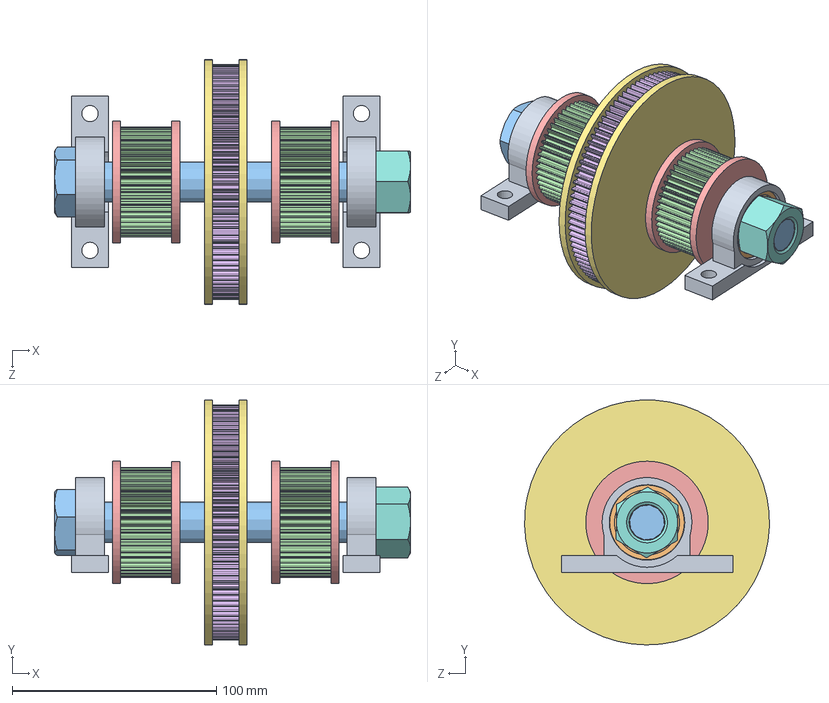
[picture p33: CAD file, 2019-04-26]
Actuador_Lineal_DiseñoGeneral/EnsambleDePoleas.SLDASM
174.4 x 119.9 x 119.9 mm
fijadores del eje x 2
radial ball bearing_68_skf x 2
hex screw gradec_din
Polea60 x 2
Protector60 x 4
Polea120
Protector120 x 2
hex nut gradec_din
