immmg/simulador-de-vuelo/Actuador_Lineal_DiseñoGeneral/ENSAMBLE GENERAL.SLDASM

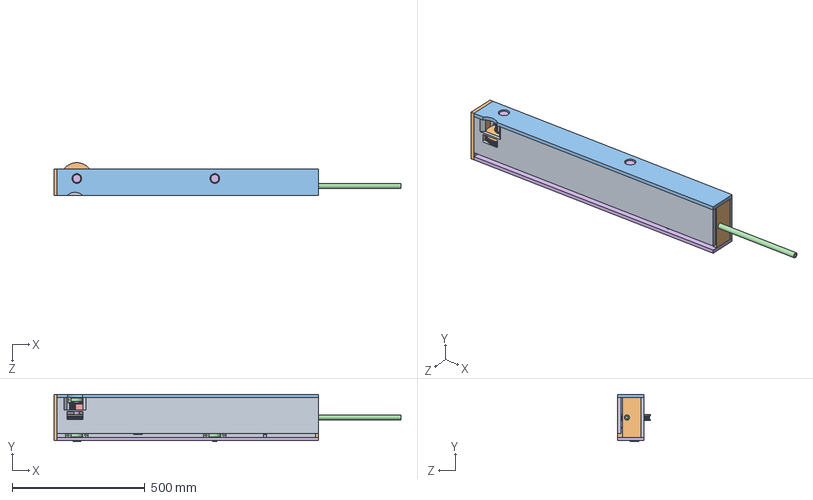
[picture p34: CAD file, 2019-04-26]
Actuador_Lineal_DiseñoGeneral/ENSAMBLE GENERAL.SLDASM
1307.6 x 177.5 x 123.5 mm
botton plate
guide block 1
guide block 2
Drive shaft
Drive shaft block
back plate
fijadores del eje x 4
radial ball bearing_68_skf x 4
hex screw gradec_din x 2
Polea60 x 4
Protector60 x 8
Polea120
Protector120 x 2
hex nut gradec_din
MicroSwitchButton2 x 2
Correa1-1^ENSAMBLE GENERAL
side plate2
