immmg/simulador-de-vuelo/Simulador de Vuelo/Actuador_Lineal/wooden drum assy.SLDPRT

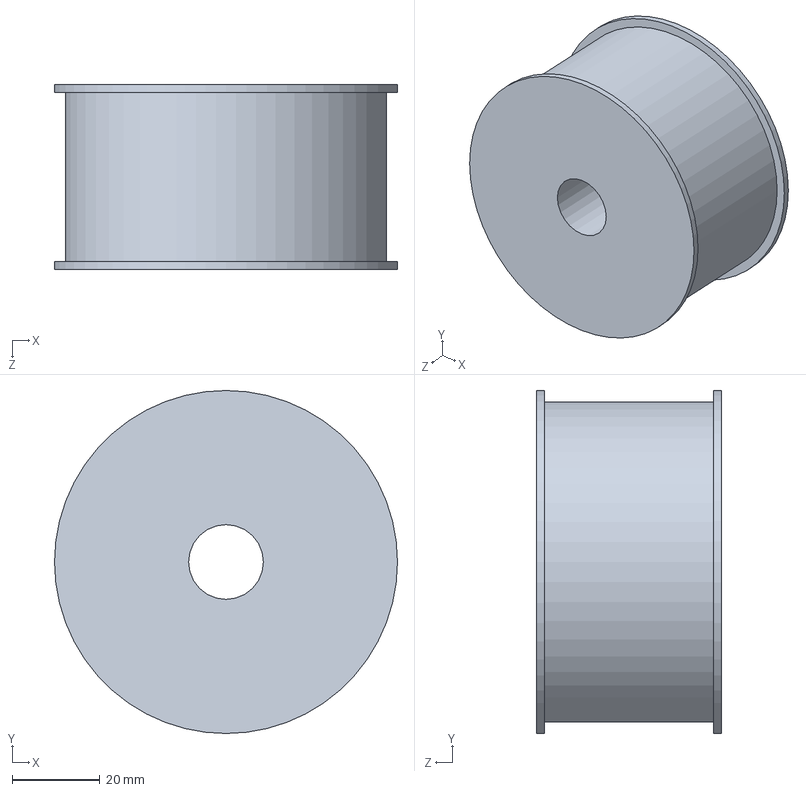
[picture p35: CAD file, 2019-04-22]
Simulador de Vuelo/Actuador_Lineal/wooden drum assy.SLDPRT
78.0 x 78.0 x 42.0 mm
