immmg/simulador-de-vuelo/Simulador de Vuelo/Actuador_Lineal/wooden drum assy eje.SLDPRT

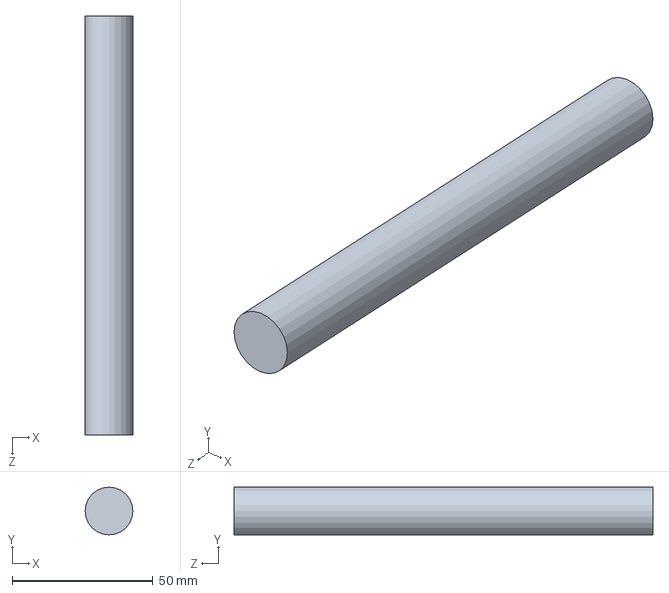
[picture p36: CAD file, 2019-04-22]
Simulador de Vuelo/Actuador_Lineal/wooden drum assy eje.SLDPRT
17.0 x 17.0 x 149.0 mm
