immmg/simulador-de-vuelo/Actuador_Lineal_DiseñoGeneral/Ensamblaje Drive shaft bracket.SLDASM

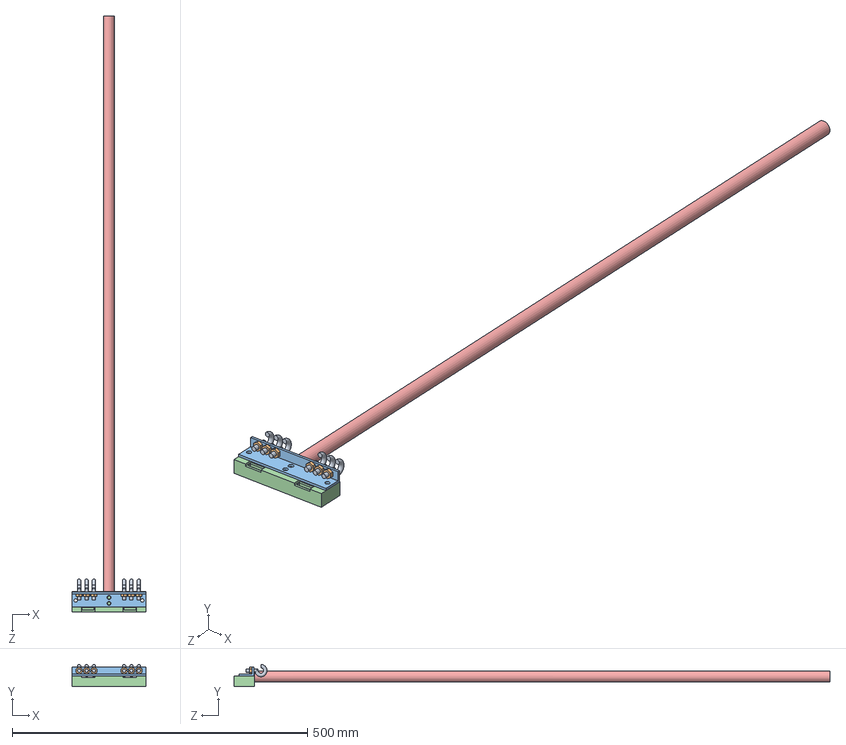
[picture p37: CAD file, 2019-04-26]
Actuador_Lineal_DiseñoGeneral/Ensamblaje Drive shaft bracket.SLDASM
126.1 x 37.5 x 1008.5 mm
Gancho x 6
tuerca x 6
Drive shaft bracket
Drive shaft block
Drive shaft
