immmg/simulador-de-vuelo/Actuador_Lineal_DiseñoGeneral/micro-limit-switch-1a-1.snapshot.5/Micro Limit Switch 1A/Micro Limit Switch 1A/MicroSwitchButton2.STEP

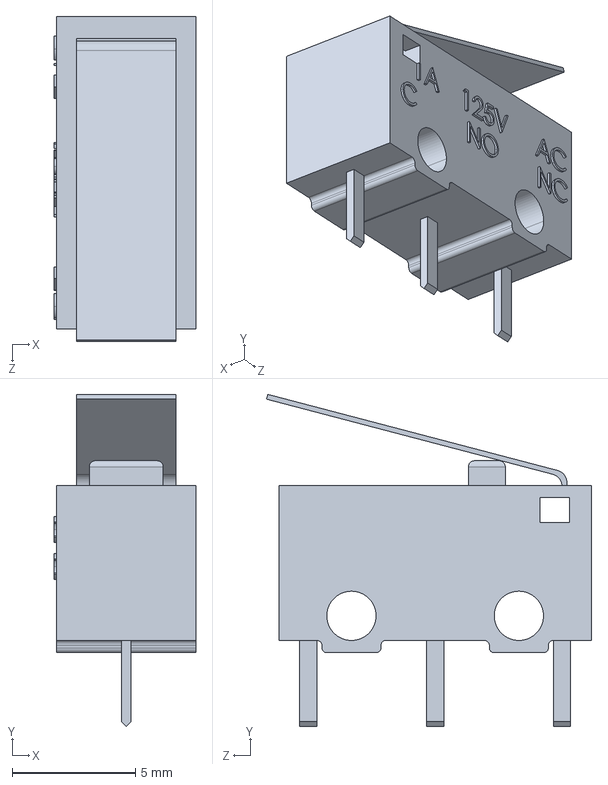
[picture p38: CAD file, 2019-04-26]
Actuador_Lineal_DiseñoGeneral/micro-limit-switch-1a-1.snapshot.5/Micro Limit Switch 1A/Micro Limit Switch 1A/MicroSwitchButton2.STEP
5.75 x 13.5 x 13.2 mm
