immmg/simulador-de-vuelo/Actuador_Lineal_DiseñoGeneral/back plate.SLDPRT

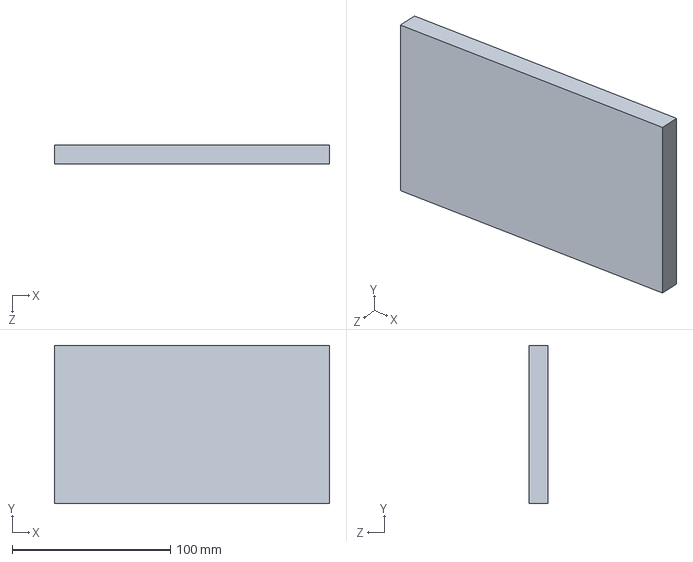
[picture p39: CAD file, 2019-04-26]
Actuador_Lineal_DiseñoGeneral/back plate.SLDPRT
174.0 x 100.0 x 12.0 mm
