immmg/simulador-de-vuelo/Simulador de Vuelo/Actuador_Lineal/Drive shaft block.SLDPRT

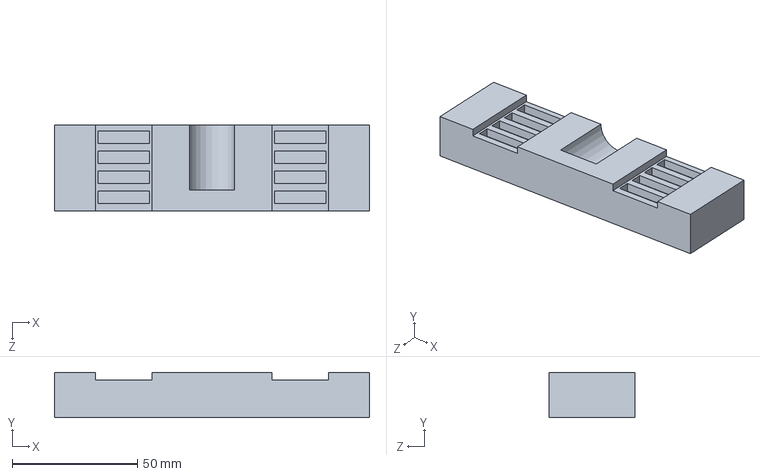
[picture p40: CAD file, 2019-04-22]
Simulador de Vuelo/Actuador_Lineal/Drive shaft block.SLDPRT
126.0 x 18.0 x 34.5 mm
