immmg/simulador-de-vuelo/Tren de engranajes (1)/Base.SLDPRT

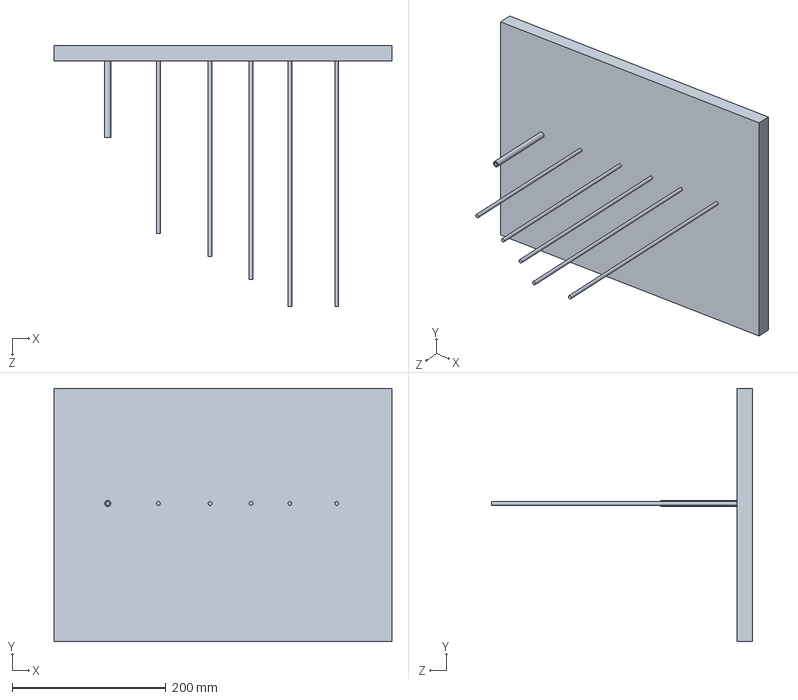
[picture p41: CAD file, 2019-04-26]
Tren de engranajes (1)/Base.SLDPRT
440.0 x 330.0 x 340.0 mm
