immmg/simulador-de-vuelo/Actuador_Lineal_DiseñoGeneral/botton plate.SLDPRT

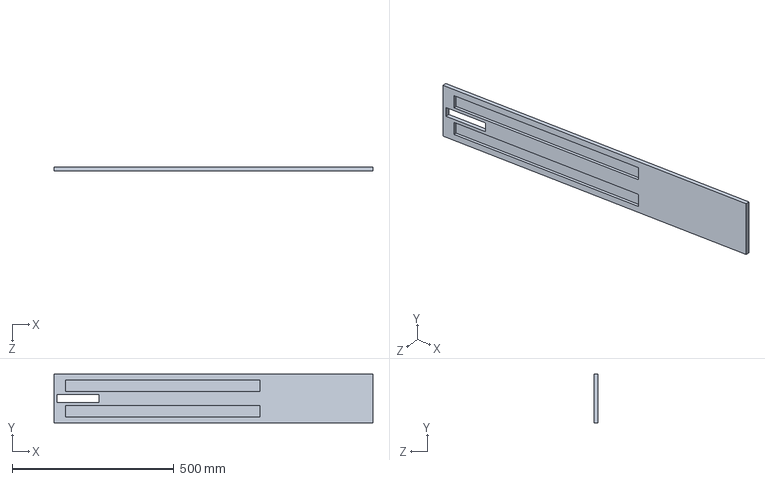
[picture p42: CAD file, 2019-04-26]
Actuador_Lineal_DiseñoGeneral/botton plate.SLDPRT
985.0 x 150.0 x 12.0 mm
