immmg/simulador-de-vuelo/Simulador de Vuelo/Actuador_Lineal/Drive shaft bracket.SLDPRT

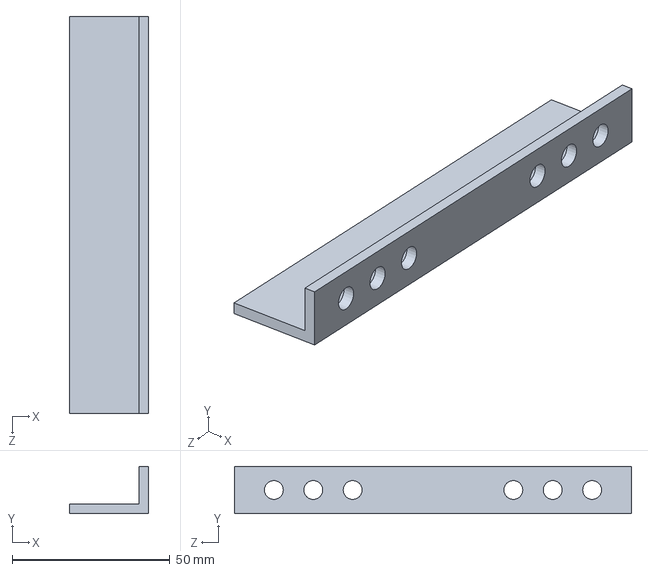
[picture p43: CAD file, 2019-04-22]
Simulador de Vuelo/Actuador_Lineal/Drive shaft bracket.SLDPRT
25.0 x 15.0 x 126.0 mm
