immmg/simulador-de-vuelo/Tren de engranajes (1)/Metric - Spur gear 2.5M 29T 20PA 20FW ---S29N75H50L5N.sldprt

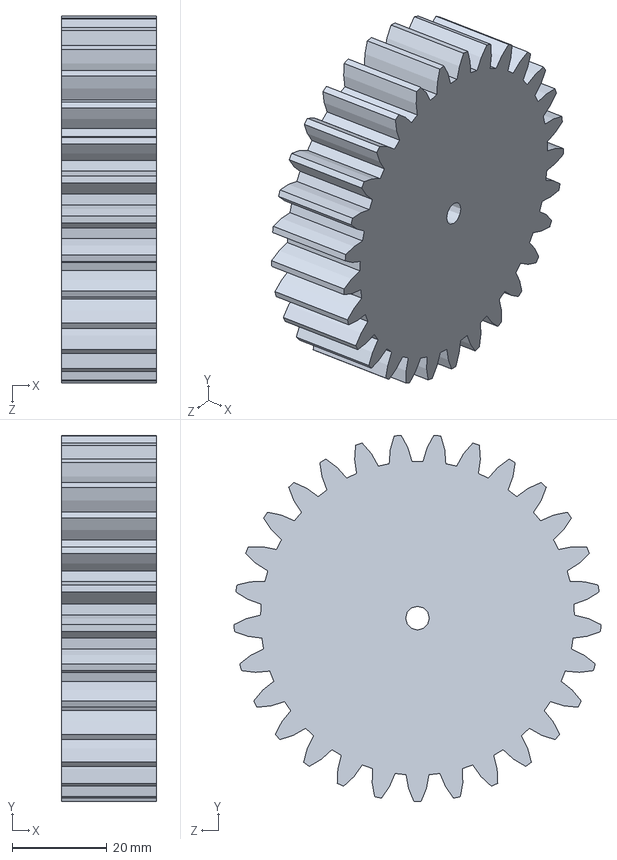
[picture p44: CAD file, 2019-04-22]
Tren de engranajes (1)/Metric - Spur gear 2.5M 29T 20PA 20FW ---S29N75H50L5N.sldprt
20.0 x 77.3 x 77.5 mm
