immmg/simulador-de-vuelo/Actuador_Lineal_DiseñoGeneral/side plate2.SLDPRT

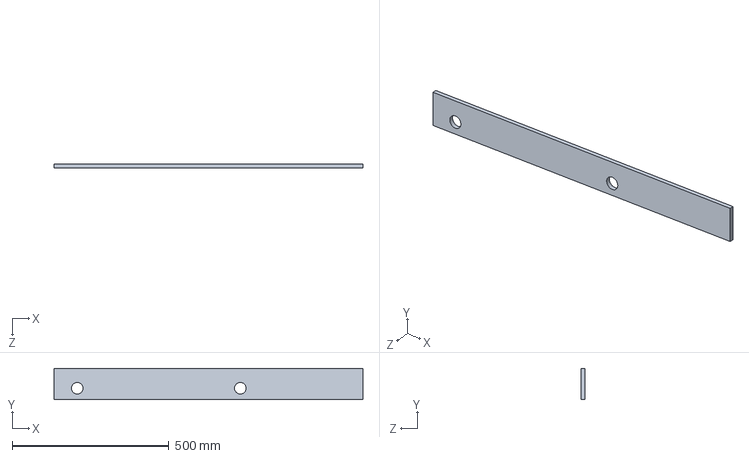
[picture p45: CAD file, 2019-04-26]
Actuador_Lineal_DiseñoGeneral/side plate2.SLDPRT
985.0 x 100.0 x 12.0 mm
