immmg/simulador-de-vuelo/Simulador de Vuelo/Actuador_Lineal/Gancho.SLDPRT

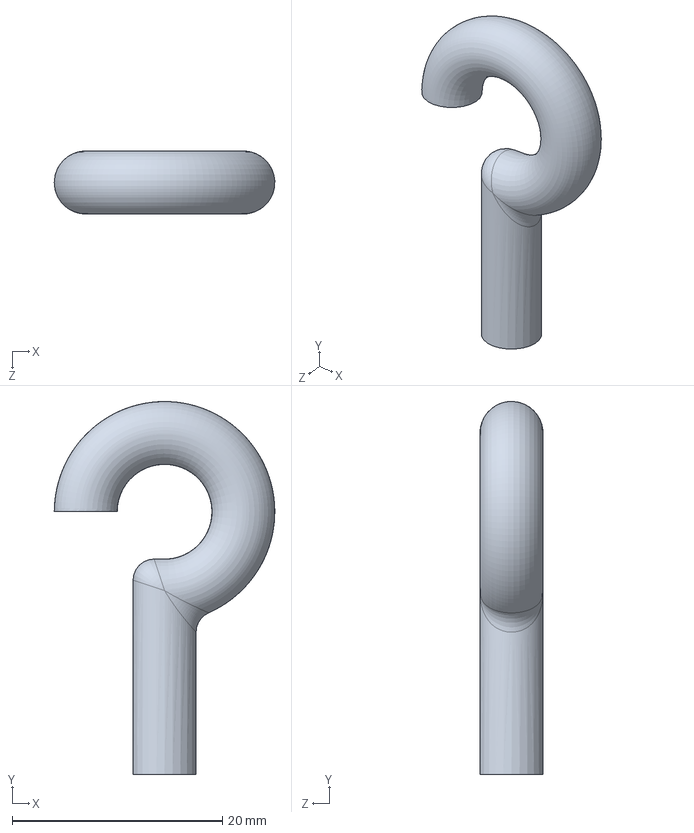
[picture p46: CAD file, 2019-04-22]
Simulador de Vuelo/Actuador_Lineal/Gancho.SLDPRT
21.0 x 35.5 x 6.00 mm
