immmg/simulador-de-vuelo/Tren de engranajes (1)/Metric - Spur gear 2.5M 18T 20PA 20FW ---S18N75H50L3N.sldprt

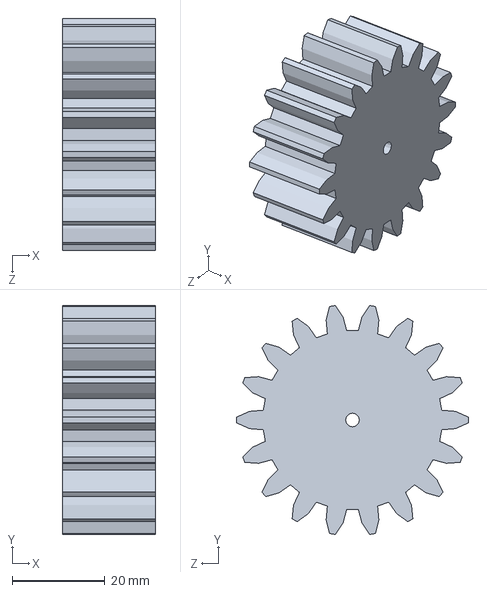
[picture p47: CAD file, 2019-04-22]
Tren de engranajes (1)/Metric - Spur gear 2.5M 18T 20PA 20FW ---S18N75H50L3N.sldprt
20.0 x 49.4 x 50.0 mm
