immmg/simulador-de-vuelo/Actuador_Lineal_DiseñoGeneral/guide block 1.SLDPRT

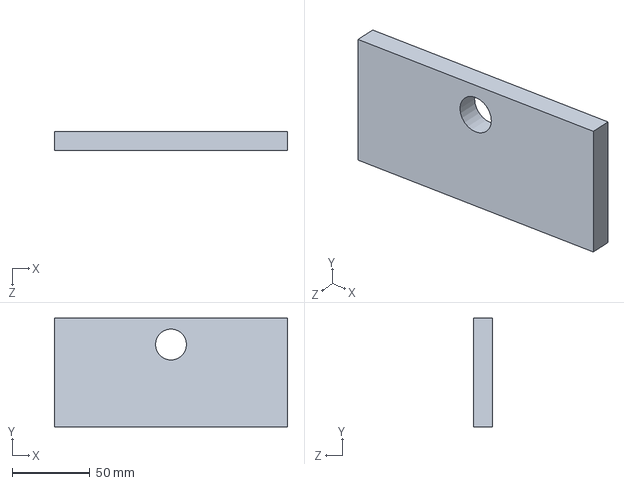
[picture p48: CAD file, 2019-04-26]
Actuador_Lineal_DiseñoGeneral/guide block 1.SLDPRT
150.0 x 70.0 x 12.0 mm
