immmg/simulador-de-vuelo/Simulador de Vuelo/Actuador_Lineal/botton plate.SLDPRT

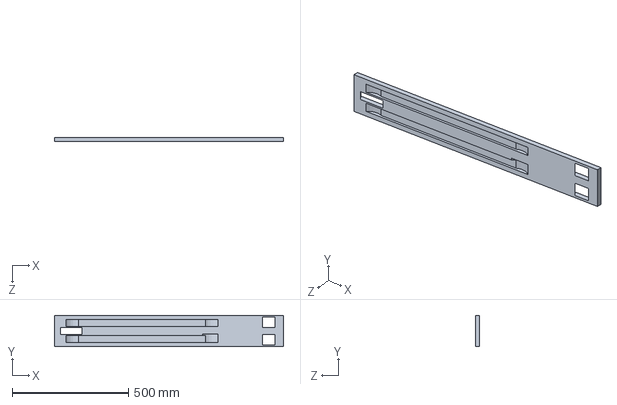
[picture p49: CAD file, 2019-04-22]
Simulador de Vuelo/Actuador_Lineal/botton plate.SLDPRT
985.0 x 135.0 x 18.0 mm
