immmg/simulador-de-vuelo/Tren de engranajes (1)/Metric - Spur gear 2.5M 15T 20PA 20FW ---S15N75H50L5N.sldprt

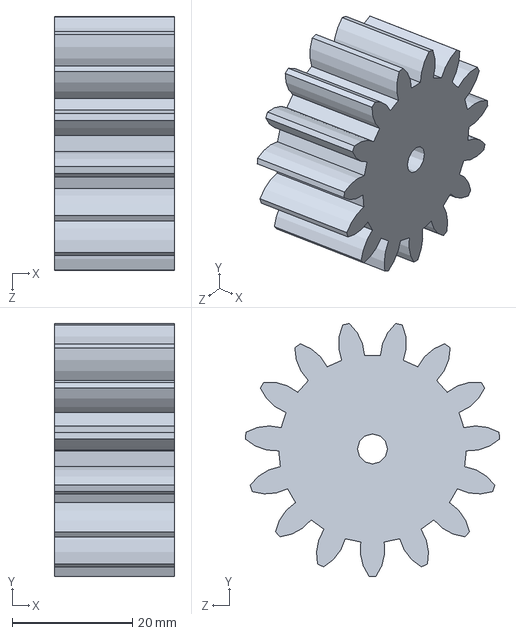
[picture p50: CAD file, 2019-04-22]
Tren de engranajes (1)/Metric - Spur gear 2.5M 15T 20PA 20FW ---S15N75H50L5N.sldprt
20.0 x 42.1 x 42.4 mm
