immmg/simulador-de-vuelo/Actuador_Lineal_DiseñoGeneral/Protector120.SLDPRT

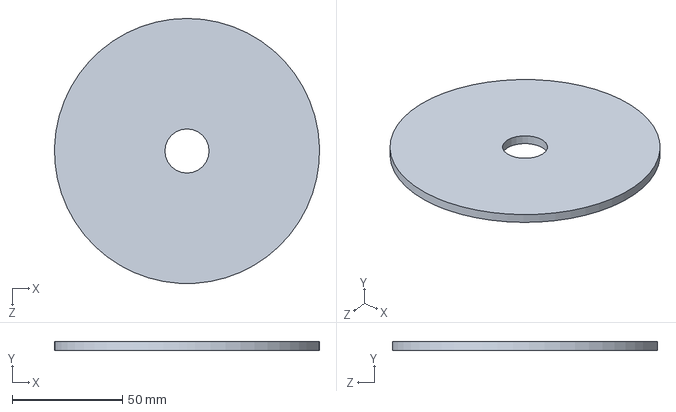
[picture p51: CAD file, 2019-04-26]
Actuador_Lineal_DiseñoGeneral/Protector120.SLDPRT
119.9 x 4.00 x 120.0 mm
