immmg/simulador-de-vuelo/Tren de engranajes (1)/High Speed 775 Motor Low Noise DC 12V-24V Large Torque Motor Ball Bearing Tools.SLDPRT

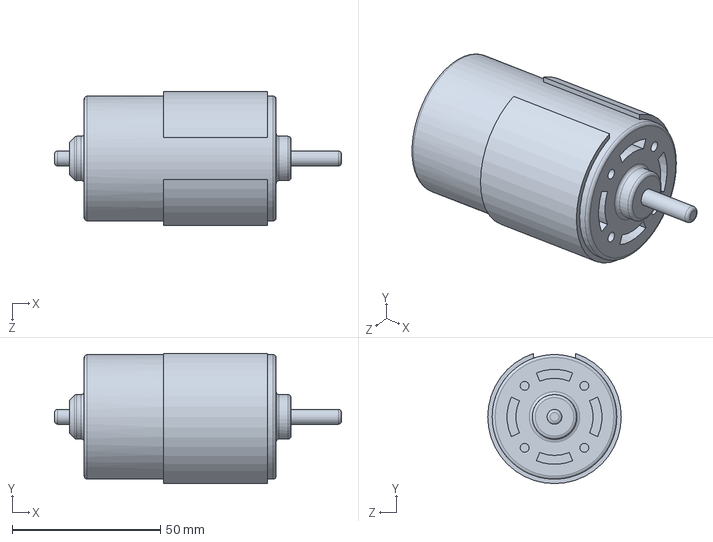
[picture p52: CAD file, 2019-04-22]
Tren de engranajes (1)/High Speed 775 Motor Low Noise DC 12V-24V Large Torque Motor Ball Bearing Tools.SLDPRT
96.7 x 43.9 x 45.0 mm
