immmg/simulador-de-vuelo/Actuador_Lineal_DiseñoGeneral/guide block 2.SLDPRT

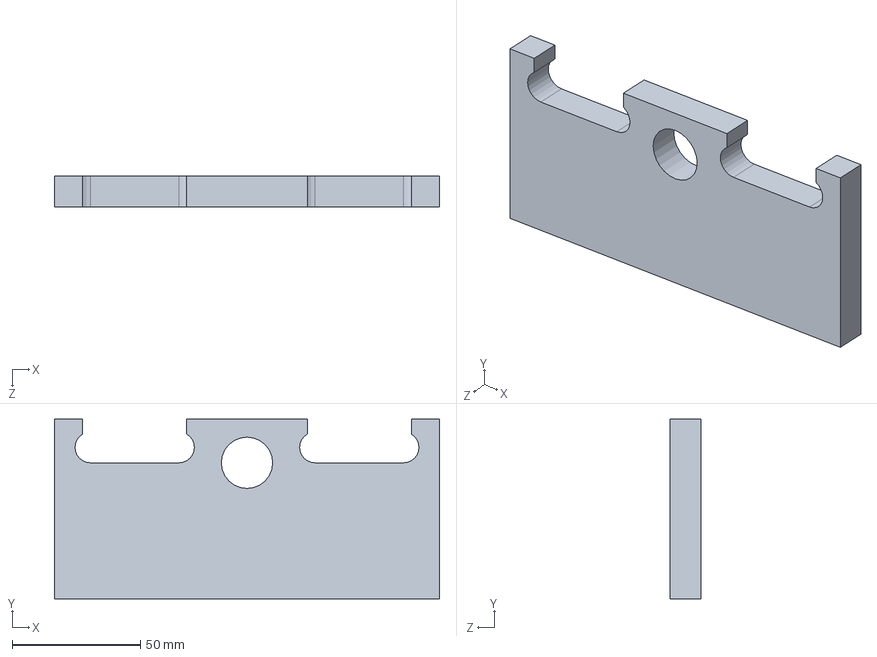
[picture p53: CAD file, 2019-04-26]
Actuador_Lineal_DiseñoGeneral/guide block 2.SLDPRT
150.0 x 70.0 x 12.0 mm
