immmg/simulador-de-vuelo/Simulador de Vuelo/Actuador_Lineal/end stop block 1.SLDPRT

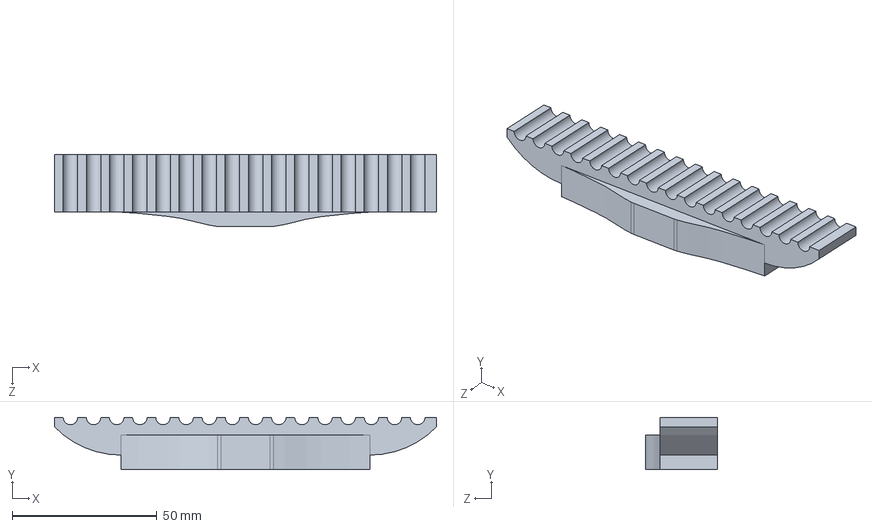
[picture p54: CAD file, 2019-04-22]
Simulador de Vuelo/Actuador_Lineal/end stop block 1.SLDPRT
132.0 x 18.0 x 25.0 mm
