immmg/simulador-de-vuelo/Tren de engranajes (1)/Metric - Spur gear 2.5M 10T 20PA 20FW ---S10N75H50L3N.sldprt

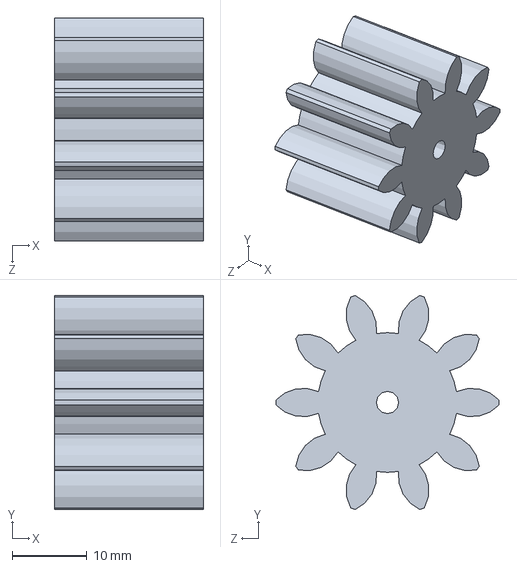
[picture p55: CAD file, 2019-04-22]
Tren de engranajes (1)/Metric - Spur gear 2.5M 10T 20PA 20FW ---S10N75H50L3N.sldprt
20.0 x 28.7 x 30.0 mm
