immmg/simulador-de-vuelo/Actuador_Lineal_DiseñoGeneral/Polea120.SLDPRT

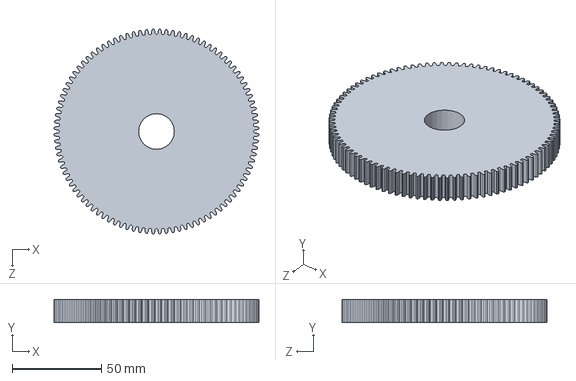
[picture p56: CAD file, 2019-04-26]
Actuador_Lineal_DiseñoGeneral/Polea120.SLDPRT
114.9 x 13.0 x 114.9 mm
