immmg/simulador-de-vuelo/Simulador de Vuelo/Actuador_Lineal/guide block 1.SLDPRT

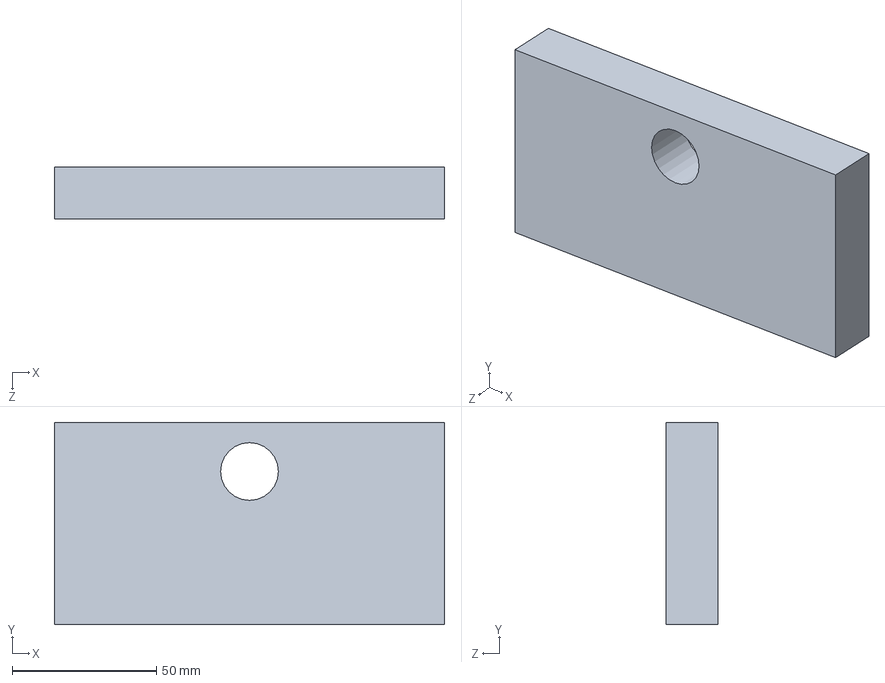
[picture p57: CAD file, 2019-04-22]
Simulador de Vuelo/Actuador_Lineal/guide block 1.SLDPRT
135.0 x 70.0 x 18.0 mm
