immmg/simulador-de-vuelo/Tren de engranajes (1)/Metric - Spur gear 2.5M 25T 20PA 20FW ---S25N75H50L5N.sldprt

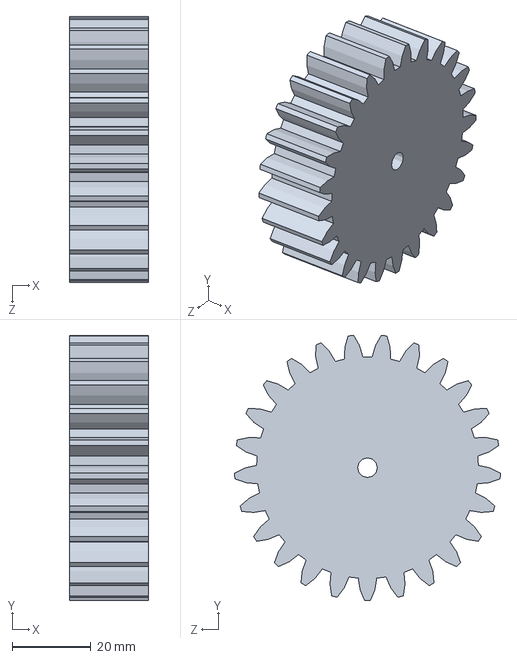
[picture p58: CAD file, 2019-04-22]
Tren de engranajes (1)/Metric - Spur gear 2.5M 25T 20PA 20FW ---S25N75H50L5N.sldprt
20.0 x 67.3 x 67.4 mm
