immmg/simulador-de-vuelo/Actuador_Lineal_DiseñoGeneral/Polea60.SLDPRT

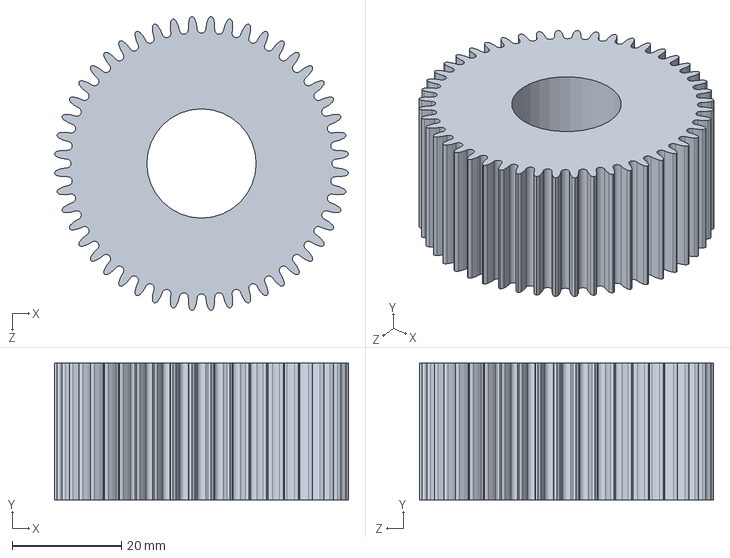
[picture p59: CAD file, 2019-04-26]
Actuador_Lineal_DiseñoGeneral/Polea60.SLDPRT
53.8 x 25.0 x 53.8 mm
