immmg/simulador-de-vuelo/Tren de engranajes (1)/Metric - Spur gear 2.5M 22T 20PA 20FW ---S22N75H50L3N.sldprt

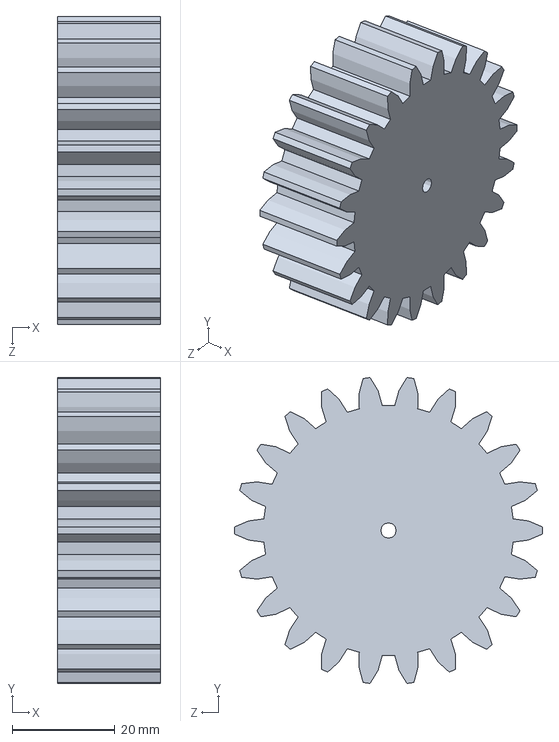
[picture p61: CAD file, 2019-04-22]
Tren de engranajes (1)/Metric - Spur gear 2.5M 22T 20PA 20FW ---S22N75H50L3N.sldprt
20.0 x 59.6 x 60.0 mm
