immmg/simulador-de-vuelo/Actuador_Lineal_DiseñoGeneral/Drive shaft block.SLDPRT

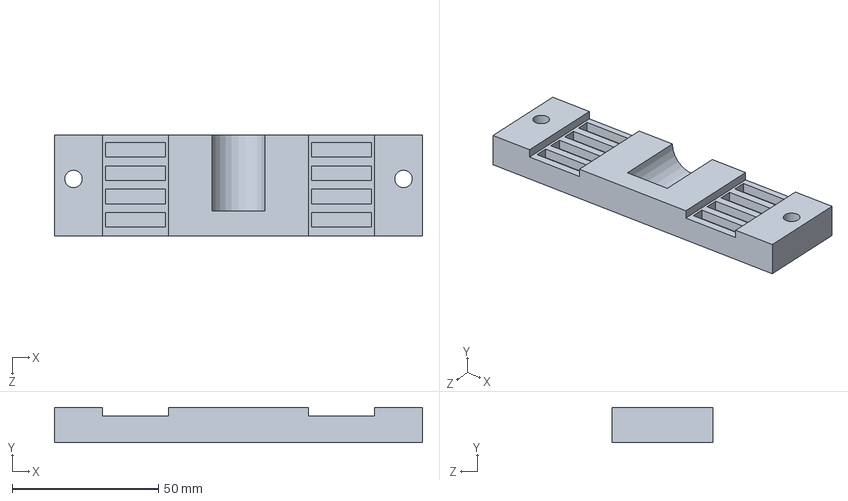
[picture p62: CAD file, 2019-04-26]
Actuador_Lineal_DiseñoGeneral/Drive shaft block.SLDPRT
126.0 x 12.0 x 34.5 mm
