immmg/simulador-de-vuelo/Simulador de Vuelo/Actuador_Lineal/bracket bungee.SLDPRT

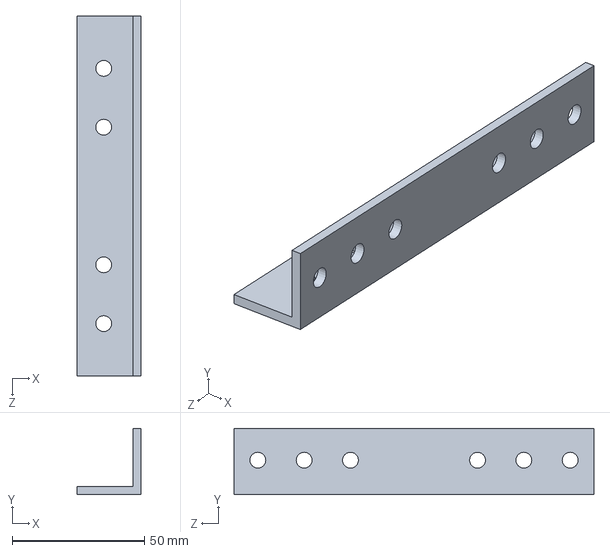
[picture p63: CAD file, 2019-04-22]
Simulador de Vuelo/Actuador_Lineal/bracket bungee.SLDPRT
24.0 x 25.0 x 136.0 mm
