immmg/simulador-de-vuelo/Tren de engranajes (1)/Metric - Spur gear 2.5M 20T 20PA 20FW ---S20N75H50L3N.sldprt

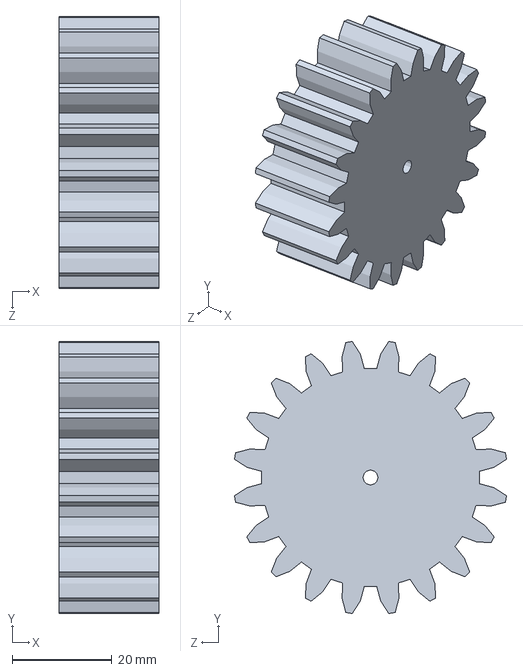
[picture p64: CAD file, 2019-04-22]
Tren de engranajes (1)/Metric - Spur gear 2.5M 20T 20PA 20FW ---S20N75H50L3N.sldprt
20.0 x 54.5 x 54.5 mm
