immmg/simulador-de-vuelo/Simulador de Vuelo/Actuador_Lineal/tuerca.SLDPRT

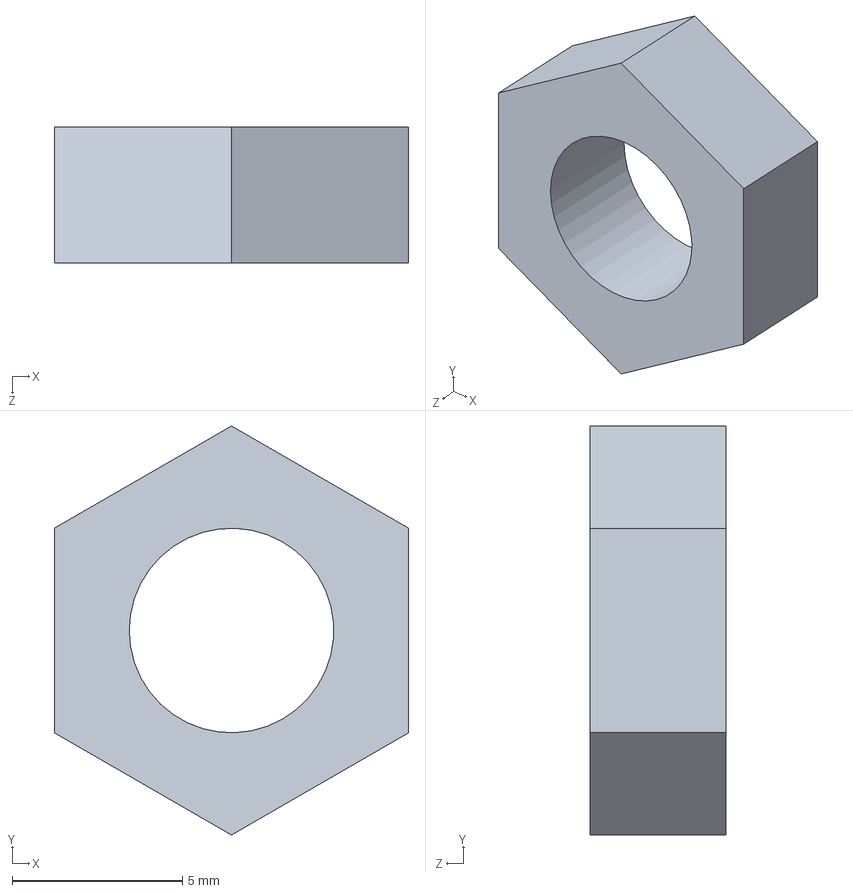
[picture p65: CAD file, 2019-04-22]
Simulador de Vuelo/Actuador_Lineal/tuerca.SLDPRT
10.4 x 12.0 x 4.00 mm
