immmg/simulador-de-vuelo/Tren de engranajes (1)/Metric - Spur gear 2.5M 44T 20PA 15FW ---S44N75H50L20N.sldprt

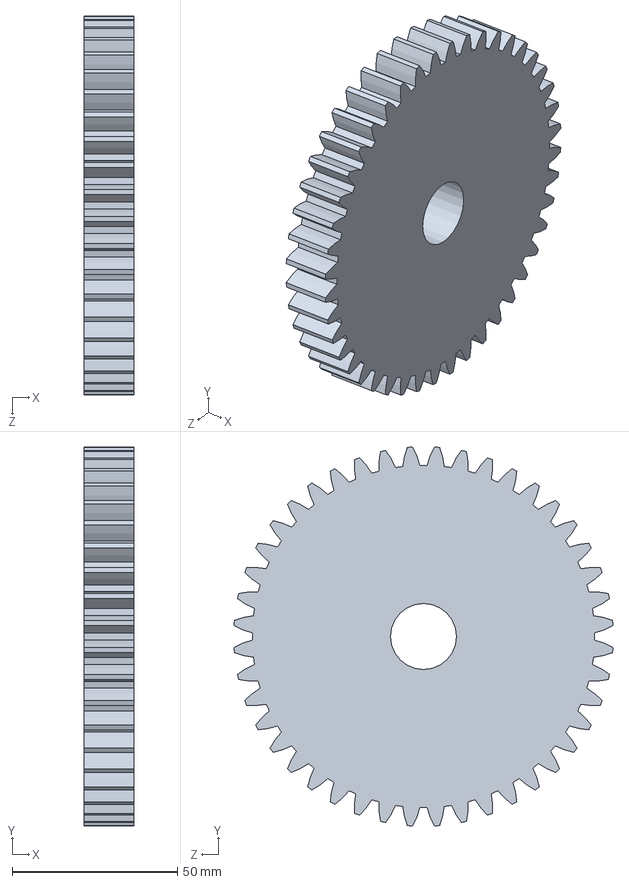
[picture p66: CAD file, 2019-04-22]
Tren de engranajes (1)/Metric - Spur gear 2.5M 44T 20PA 15FW ---S44N75H50L20N.sldprt
15.0 x 114.8 x 114.8 mm
