immmg/simulador-de-vuelo/Tren de engranajes (1)/Metric - Spur gear 2.5M 44T 20PA 20FW ---S44N75H50L5N.sldprt

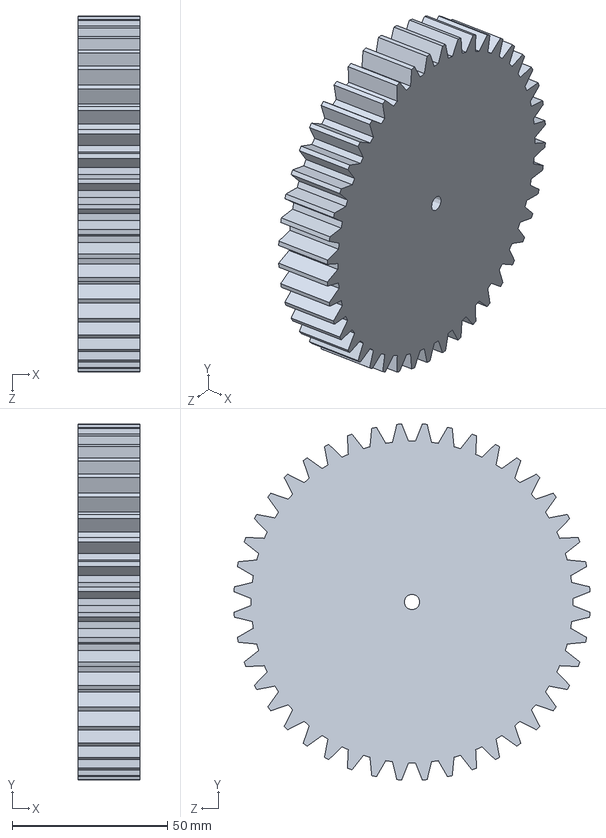
[picture p67: CAD file, 2019-04-22]
Tren de engranajes (1)/Metric - Spur gear 2.5M 44T 20PA 20FW ---S44N75H50L5N.sldprt
20.0 x 114.8 x 114.8 mm
