immmg/simulador-de-vuelo/Actuador_Lineal_DiseñoGeneral/Protector60.SLDPRT

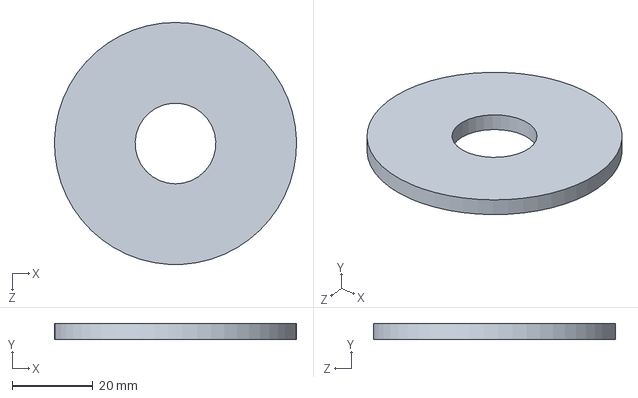
[picture p68: CAD file, 2019-04-26]
Actuador_Lineal_DiseñoGeneral/Protector60.SLDPRT
60.0 x 4.00 x 60.0 mm
