immmg/simulador-de-vuelo/Simulador de Vuelo/Actuador_Lineal/back plate.SLDPRT

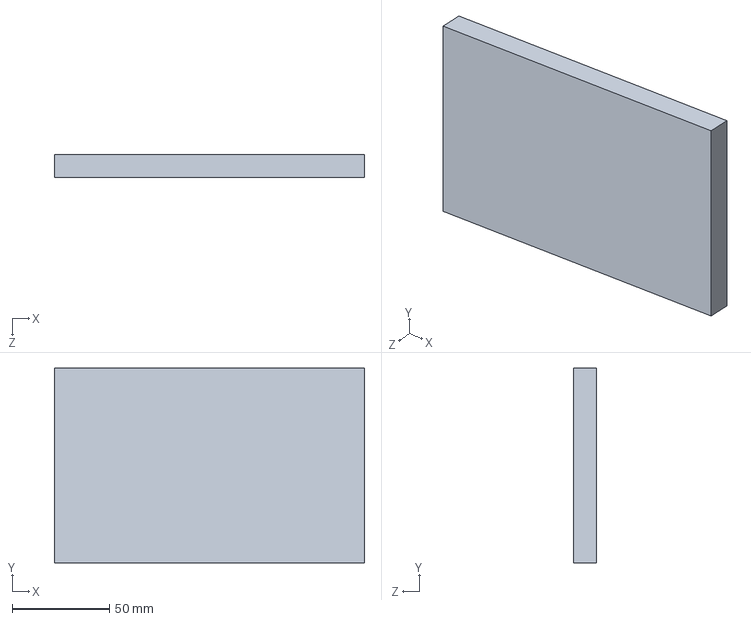
[picture p69: CAD file, 2019-04-22]
Simulador de Vuelo/Actuador_Lineal/back plate.SLDPRT
159.0 x 100.0 x 12.0 mm
