immmg/simulador-de-vuelo/Tren de engranajes (1)/Metric - Spur gear 2.5M 31T 20PA 20FW ---S31N75H50L5N.sldprt

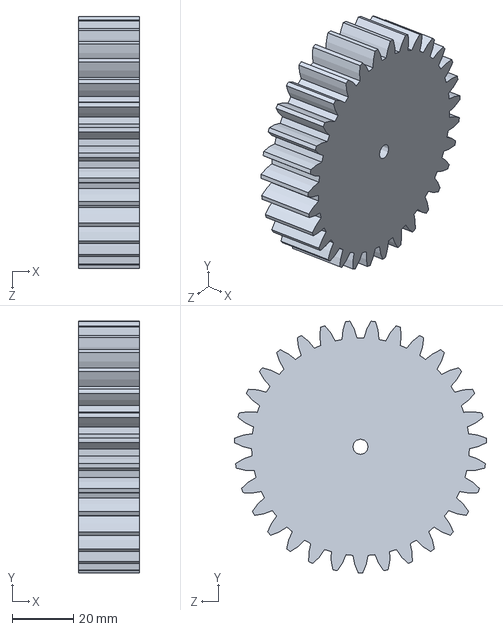
[picture p70: CAD file, 2019-04-22]
Tren de engranajes (1)/Metric - Spur gear 2.5M 31T 20PA 20FW ---S31N75H50L5N.sldprt
20.0 x 82.4 x 82.5 mm
