immmg/simulador-de-vuelo/Tren de engranajes (1)/Metric - Spur gear 2.5M 28T 20PA 20FW ---S28N75H50L5N.sldprt

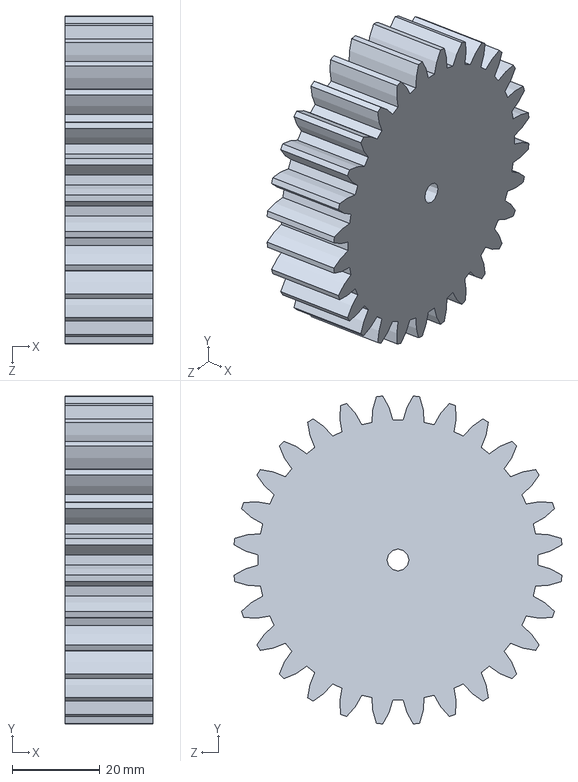
[picture p71: CAD file, 2019-04-22]
Tren de engranajes (1)/Metric - Spur gear 2.5M 28T 20PA 20FW ---S28N75H50L5N.sldprt
20.0 x 74.7 x 74.7 mm
