immmg/simulador-de-vuelo/Simulador de Vuelo/Actuador_Lineal/Drive shaft.SLDPRT

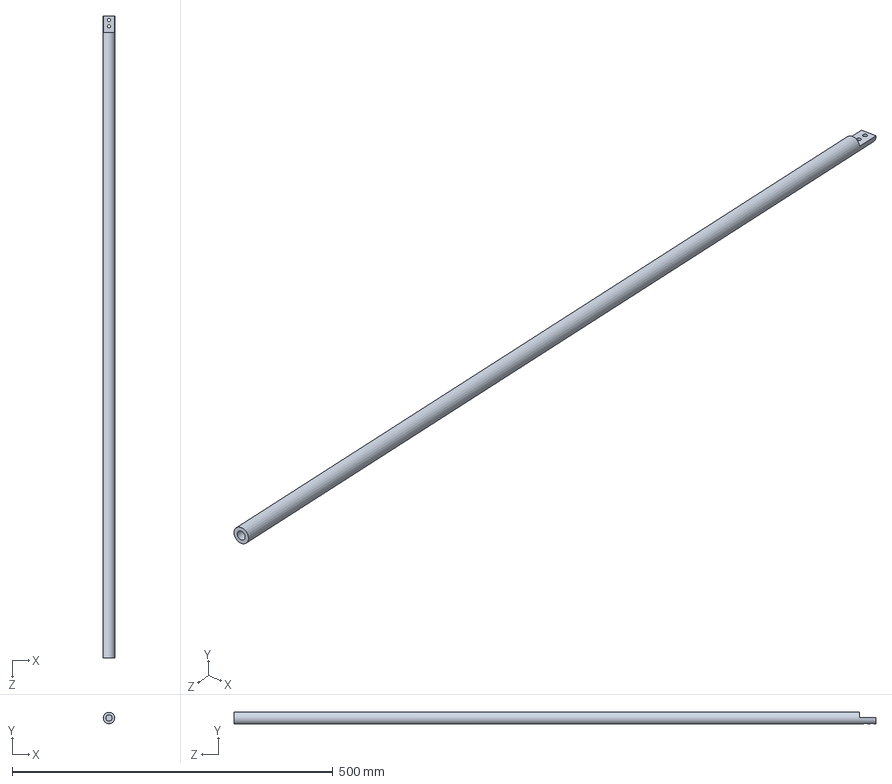
[picture p72: CAD file, 2019-04-22]
Simulador de Vuelo/Actuador_Lineal/Drive shaft.SLDPRT
18.0 x 18.0 x 1000.0 mm
