immmg/simulador-de-vuelo/Actuador_Lineal_DiseñoGeneral/Polea40.SLDPRT

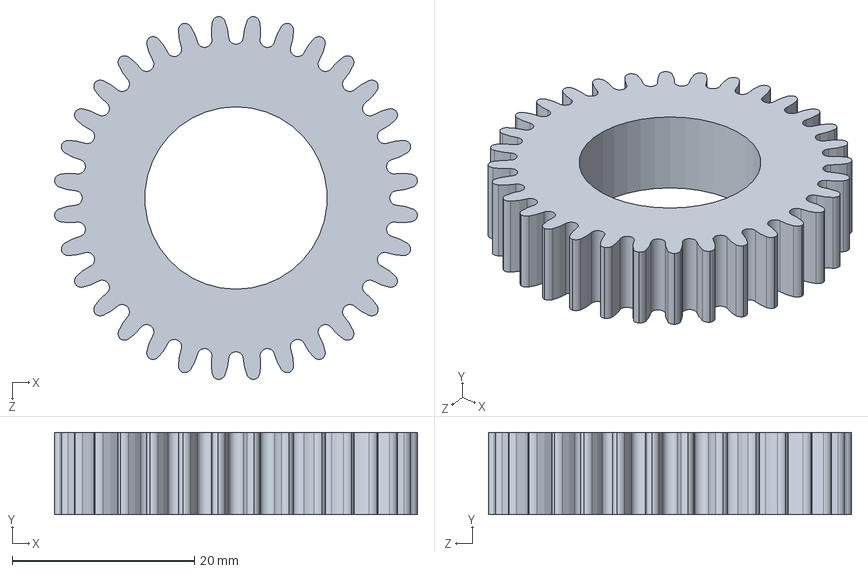
[picture p73: CAD file, 2019-04-22]
Actuador_Lineal_DiseñoGeneral/Polea40.SLDPRT
39.8 x 9.00 x 39.8 mm
