immmg/simulador-de-vuelo/Simulador de Vuelo/Actuador_Lineal/fijadores del eje.SLDPRT

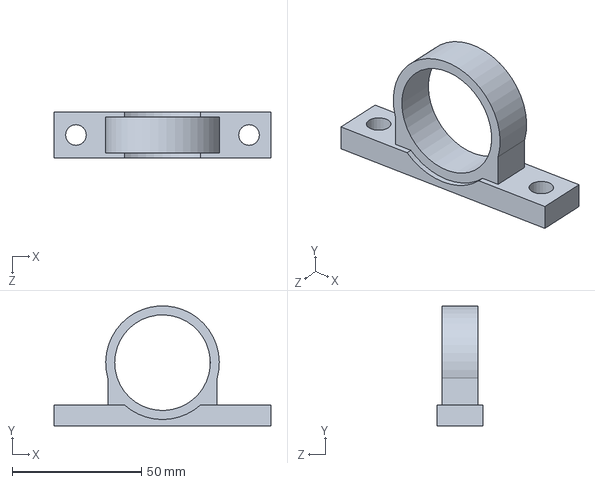
[picture p74: CAD file, 2019-04-22]
Simulador de Vuelo/Actuador_Lineal/fijadores del eje.SLDPRT
84.0 x 46.4 x 18.0 mm
