immmg/simulador-de-vuelo/Actuador_Lineal_DiseñoGeneral/Protector40.SLDPRT

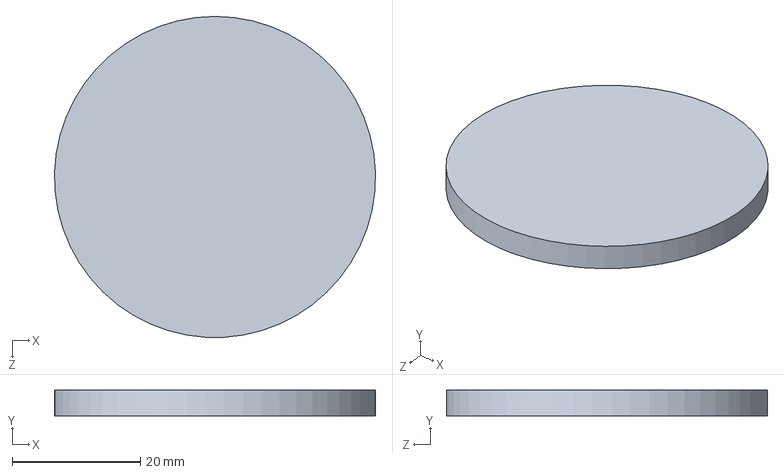
[picture p75: CAD file, 2019-04-22]
Actuador_Lineal_DiseñoGeneral/Protector40.SLDPRT
50.0 x 4.00 x 50.0 mm
