immmg/simulador-de-vuelo/Actuador_Lineal_DiseñoGeneral/polea tensionadora1.SLDPRT

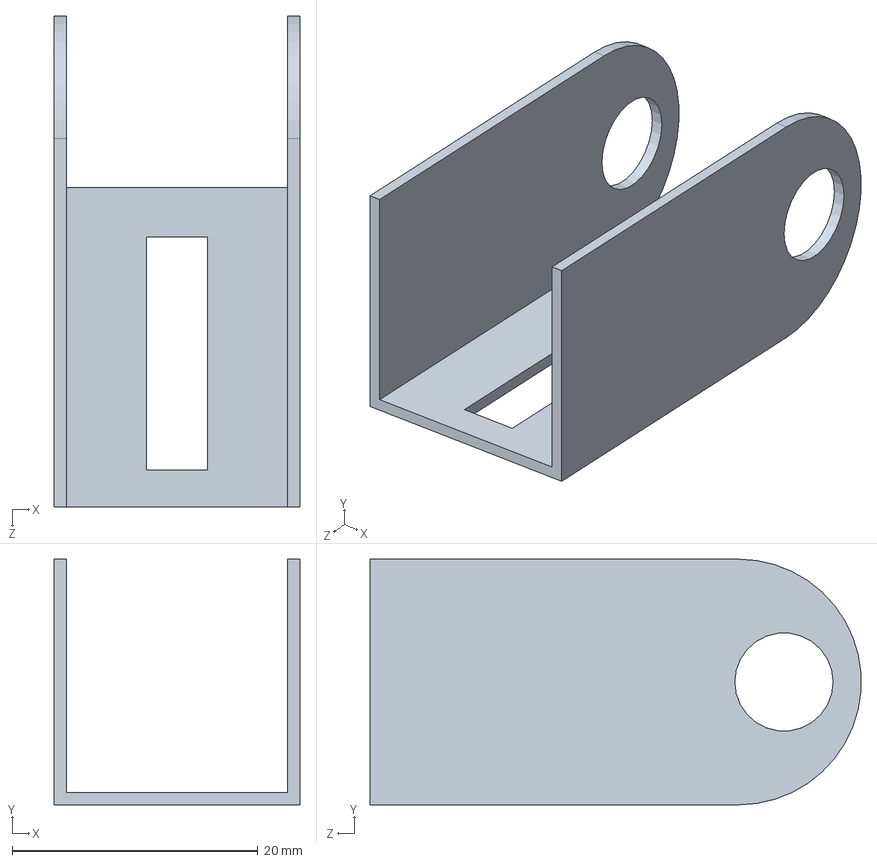
[picture p76: CAD file, 2019-04-22]
Actuador_Lineal_DiseñoGeneral/polea tensionadora1.SLDPRT
20.0 x 20.0 x 40.0 mm
