immmg/simulador-de-vuelo/Actuador_Lineal_DiseñoGeneral/eje poleas.SLDPRT

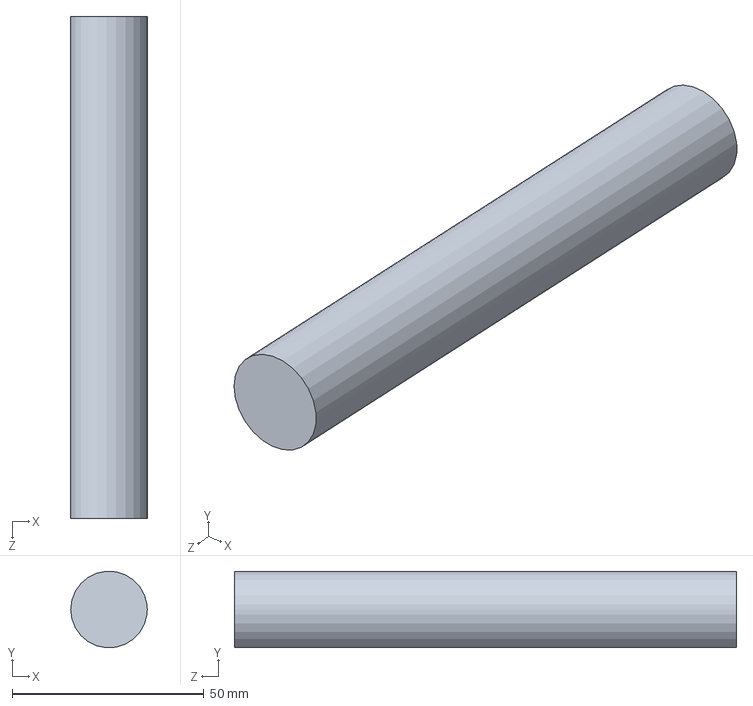
[picture p77: CAD file, 2019-04-22]
Actuador_Lineal_DiseñoGeneral/eje poleas.SLDPRT
20.0 x 20.0 x 131.0 mm
