immmg/simulador-de-vuelo/Actuador_Lineal_DiseñoGeneral/Top plate.SLDPRT

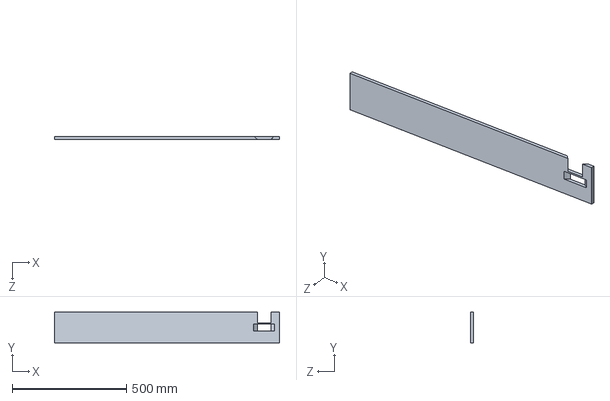
[picture p78: CAD file, 2019-04-22]
Actuador_Lineal_DiseñoGeneral/Top plate.SLDPRT
985.0 x 135.0 x 12.0 mm
