immmg/simulador-de-vuelo/Actuador_Lineal_DiseñoGeneral/Polea tensionadora.SLDPRT

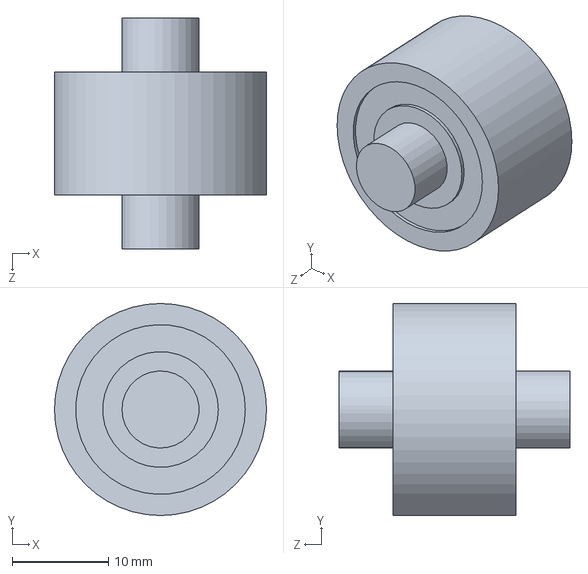
[picture p79: CAD file, 2019-04-22]
Actuador_Lineal_DiseñoGeneral/Polea tensionadora.SLDPRT
22.0 x 22.0 x 24.0 mm
