immmg/simulador-de-vuelo/(list of files, cad)

Other CAD files:
Simulador de Vuelo/Actuador_Lineal/Ensamblaje 8M drive assy.SLDASM
Especificacion de Requerimientos/Electronica/esquema_electrico.dwg
Programacion/SCH/Drawing1.dwg
Simulador de Vuelo/Actuador_Lineal/side plate2.SLDPRT
Simulador de Vuelo/Actuador_Lineal/side plate1.SLDPRT
Tren de engranajes (1)/Metric - Spur gear 2.5M 44T 20PA 20FW ---S44N75H50L5M.sldprt
Actuador_Lineal_DiseñoGeneral/side plate1.SLDPRT
Tren de engranajes (1)/Metric - Spur gear 2.5M 22T 20PA 20FW ---S22N75H50L5N.sldprt
Tren de engranajes (1)/Metric - Spur gear 2.5M 20T 20PA 20FW ---S20N75H50L5N.sldprt
Actuador_Lineal_DiseñoGeneral/hex screw gradec_din.sldprt
Actuador_Lineal_DiseñoGeneral/micro-limit-switch-1a-1.snapshot.5/Micro Limit Switch 1A/Micro Limit Switch 1A/MicroSwitchButton2.IGS
Actuador_Lineal_DiseñoGeneral/micro-limit-switch-1a-1.snapshot.5/Micro Limit Switch 1A/Micro Limit Switch 1A/MicroSwitchButton2.SLDPRT
Actuador_Lineal_DiseñoGeneral/micro-limit-switch-1a-1.snapshot.5/Micro Limit Switch 1A/Micro Limit Switch 1A/MicroSwitchButton2.STL
Simulador de Vuelo/EnsambleDePoleas.SLDASM
Simulador de Vuelo/Polea120.SLDPRT
Simulador de Vuelo/Polea60.SLDPRT
Simulador de Vuelo/Protector120.SLDPRT
Simulador de Vuelo/Protector60.SLDPRT
