immmg/simulador-de-vuelo/Especificacion de Requerimientos/Electronica/esquema_electrico_FINAL.pdf

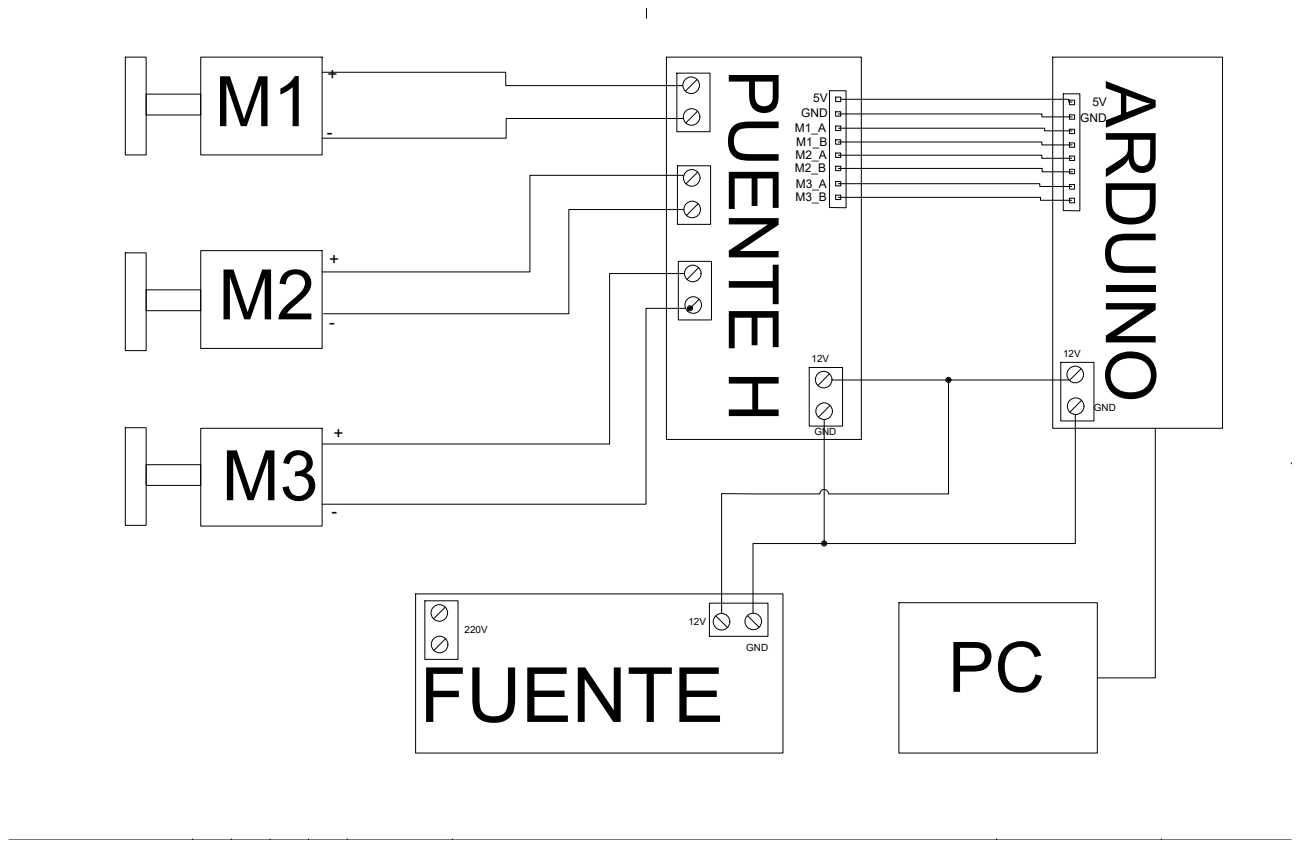
[picture p80: page 1]
PUENTE H

ARDUINO -+-+- PC 12V 5V GND M1_A M1_B M2_A M2_B M3_A M3_B 5V GND FUENTE 12V GND GND 12V GND 220V
