immmg/simulador-de-vuelo/Programacion/SCH/Drawing1.pdf

# IMMG INGENIERIA

# https://github.com/immmg

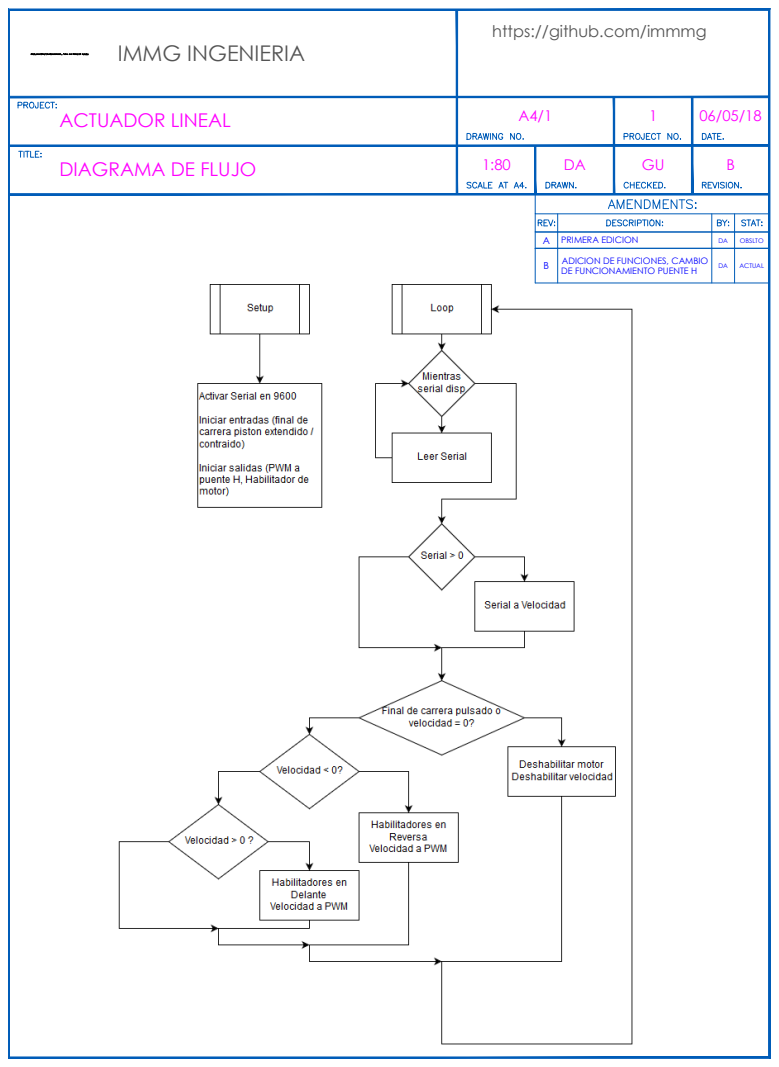
[picture p81: page 1]
ACTUADOR LINEAL; PRIMERA EDICION; OBSLTO; ADICION DE FUNCIONES, CAMBIO; DE FUNCIONAMIENTO PUENTE H; ACTUAL

DIAGRAMA DE FLUJO
