immmg/simulador-de-vuelo/(list of files, drawings)

Other design files:
PUENTE H- 220V/puente h para 220v.pdsprj
puente_H/puente_h.pdsprj
