immmg/simulador-de-vuelo/(commit log)

2019-04-15 Añadido esquema electronico
    [esquema_electrico.dwg]
2019-04-21 controlador de motor (8amp, 24v)
    [puente_h.pdsprj]
2019-04-21 Subido sketch propuesto de Arduino
2019-04-22 Diseño de la caja
    [Drive shaft block.SLDPRT, Drive shaft bracket.SLDPRT, Drive shaft.SLDPRT, ENSAMBLE GENERAL.SLDASM, Ensamblaje 8M drive assy.SLDASM, Ensamblaje Drive shaft bracket.SLDASM, Gancho.SLDPRT, Polea tensionadora.SLDPRT]
2019-04-26 Programacion - Diagrama de Flujo
2019-04-26 Creado presupuesto - 1ra revision
    [Presupuesto.xlsx]
2019-04-26 SUBIDO LA COMPARACION DE MOTORES
    ALGUNOS DATOS FUERON OBTENIDOS DE FOROS EN INTERNET, POR QUE EL MOTOR ERA DESCONOCIDO, Y SE TUVIERON QUE HACER CÁLCULOS ADICIONALES DE IGUAL MANERA.
    [comparacion de motores_final.xlsx]
2019-04-26 PUENTE H PARA MOTOR DE CAMINADORA
    Diseñado con componentes que puedan soportar el voltaje que maneja el motor, se puede variar la velocidad con pulsos pwm e invertir giros.
    [puente h para 220v.pdsprj]
2019-04-26 hay componentes aún por definir
    [Presupuesto Estructura.xlsx]
2019-04-26 Documentos actualizados
    [Drive shaft block.SLDPRT, ENSAMBLE GENERAL.SLDASM, Ensamblaje 8M drive assy.SLDASM, Ensamblaje Drive shaft bracket.SLDASM, EnsambleDePoleas.SLDASM, MicroSwitchButton2.IGS, MicroSwitchButton2.SLDPRT, MicroSwitchButton2.STEP]
2019-04-29 Actualizado programa para un solo Actuador
2019-05-03 Actualizada programacion / Insertado programa RTOS
2019-05-05 Actualizada hoja de diagrama de flujo
    [Drawing1.dwg]
2019-05-05 More typos
    [Drawing1.dwg]
2019-05-19 Add files via upload
    Actuador lineal con diseno para corte laser cnc
